sebabelz/SolderPi/pcb/bom.xlsx

Sheet: simple
Qty | Value | Device | Package | Parts | Description | OC_MOUSER | OC_DIGIKEY
2 |  | PINHD-1X2 | 1X02 | X4, X6 | PIN HEADER | 855-M20-9990246 | 952-2262-ND
1 | PINHD-2X2 | PINHD-2X2 | 2X02 | X10 | PIN HEADER | 571-5-146254-2 | 609-3242-ND
1 | 32768kHz | 9HT11 | 2X1.2 | Q2 |  | 717-9HT11-32.7KDZC-T | 887-1426-1-ND
1 | B3S-1000 | B3S-1000 | B3S | X9 |  | 653-B3S-1000 | SW415-ND
1 | MICRO-LATCH-4 | MICRO-LATCH-4 | buchse | X5 |  | 538-53253-0470 | WM19006-ND
1 | NANOFIT-2 | NANOFIT-2 | buchse |  |  | 538-105313-1102 | WM16893-ND
1 | NANOFIT-7 | NANOFIT-7 | buchse | X7 |  | 538-105313-1107 | WM16898-ND
1 | 470ÂµF | C-EEEFK | C_EEEFK-10X10 | C1 |  | 667-EEE-FK1E471P | PCE3805CT-ND
7 | 100nF | C-EUC0402 | C0402 | C11, C12, C14, C15, C16, C22, C23 | CAPACITOR, European symbol | 710-885012105016 | 732-7493-1-ND
2 | 12pF | C-EUC0402 | C0402 | C17, C18 | CAPACITOR, European symbol | 77-VJ0402A120JXAPBC | 399-1013-1-ND
2 | 1ÂµF | C-EUC0402 | C0402 | C10, C24 | CAPACITOR, European symbol | 81-GRM155R61C105MA2D | 490-12237-1-ND
2 | 22pF | C-EUC0402 | C0402 | C19, C21 | CAPACITOR, European symbol | 710-885012005027 | 732-7443-1-ND
1 | 100pF | C-EUC0603 | C0603 | C20 | CAPACITOR, European symbol | 710-885012006023 | 732-7766-1-ND
2 | 150nF | C-EUC0603 | C0603 | C7, C9 | CAPACITOR, European symbol | 810-C1608X5R1E154K | 445-7472-1-ND
2 | 1nF | C-EUC0603 | C0603 | C6, C8 | CAPACITOR, European symbol | 710-885012206059 | 732-7978-1-ND
5 | 10ÂµF | C-EUC0805 | C0805 | C2, C3, C4, C5, C14 | CAPACITOR, European symbol | 81-GRM21BR61E106MA3L | 1276-6471-1-ND
10 | MICRO-LATCH-4 | MICRO-LATCH-4 | crimp |  |  | 538-50212-8000-CT | WM4561CT-ND
10 | NANOFIT | NANOFIT | crimp |  |  | 538-105300-1100 | WM16863CT-ND
2 | JTAG-EDGE-CON | JTAG-EDGE-CON | DEBUG-CON | X8 |  | 649-1001878311110TLF | 609-1977-ND
1 | 24MHz | XRCHA_F_A | HCR2520 | Q1 |  | 81-XRCHA24M000F0A1R0 | 490-9652-1-ND
1 | IGRID-10 | IGRID-10 | IGRID-10 |  |  | 538-501646-1000 | WM6058-ND
1 | IGRID-10 | IGRID-10 | I-GRID-10 | X3 |  | 538-501645-1020 | WM6072-ND
1 | IGRID-14 | IGRID-14 | I-GRID-14 |  |  | 538-501645-1420 | WM6074-ND
1 | IGRID-14 | IGRID-14 | I-GRID-14 | X2 |  | 538-501646-1400 | WM6060-ND
1 | 50R @ 20MHz | L-0603 | L0603 | L1 |  | 81-BLM18AG151SZ1D | 732-1579-1-ND
1 | NANOFIT-2 | NANOFIT-2 | prot | X1 |  | 538-105325-1002 | WM15187-ND
1 | NANOFIT-7 | NANOFIT-7 | prot |  |  | 538-105325-1007 | WM15192-ND
2 | 1k1 | R-EU_R0603 | R0603 | R10, R16 | RESISTOR, European symbol | 603-AC0603FR-071K1L | 311-1.10KHRCT-ND
2 | 210k | R-EU_R0603 | R0603 | R4, R14 | RESISTOR, European symbol | 603-RC0603FR-10220KL | 311-210KHRCT-ND
1 | 2k2 | R-EU_R0603 | R0603 | R18 | RESISTOR, European symbol | 603-RC0603FR-072K2L | 311-2.20KHRCT-ND
1 | 330 | R-EU_R0603 | R0603 | R19 | RESISTOR, European symbol | 594-MCT06030C3300FP5 | MCT0603-330-CFCT-ND
4 | 4.7k | R-EU_R0603 | R0603 | R1, R2, R11, R12 | RESISTOR, European symbol | 603-RC0603FR-0710KL | 311-10.0KHRCT-ND
2 | 665k | R-EU_R0603 | R0603 | R3, R13 | RESISTOR, European symbol | 71-CRCW0603-665K-E3 | 311-665KHRCT-ND
4 | 4,7k | R-EU_R0805 | R0805 | R5, R6, R7, R9 | RESISTOR, European symbol | 652-CR0805-FX4701GLF | CR0805-FX-4701GLFCT-ND
2 | 20m | R-EU_R1206 | R1206 | R8, R15 | RESISTOR, European symbol | 791-WW12DR020FTL | MCS1632R020FERCT-ND
1 | 0 | R-EU_R1210 | R1210 | R17 | RESISTOR, European symbol | 603-AC1210JR-070RL | YAG3990CT-ND
2 | IRF9392PBF | IRF9392PBF | SO8 | T2, T4 |  | 942-IRF9392TRPBF | IRF7416TRPBFCT-ND
1 | LD1117S50C | LD1117S50C | SOT223 | IC1 |  | 511-LD1117S50C-TR | 497-1243-1-ND
2 | NVR4003NT3G | NVR4003NT3G | SOT23 | T1, T3 |  | 863-NVR4003NT3G | NVR4003NT3GOSCT-ND
1 |  | mcp1802 | SOT23-5L | IC3 |  | 998-MIC5504-3.3YM5TR | MCP1802T-3302I/OTCT-ND
2 | INA196 | INA196 | SOT23-5L | IC4, IC5 |  | 595-INA196AIDBVT | 296-17166-1-ND
1 | MICRO-LATCH-4 | MICRO-LATCH-4 | stecker |  |  | 538-51065-0400 | WM19011-ND
1 | NANOFIT-2 | NANOFIT-2 | stecker |  |  | 538-105307-1202 | WM14958-ND
1 | NANOFIT-7 | NANOFIT-7 | stecker |  |  | 538-105307-1207 | WM15013-ND
1 | ATSAMC21G | ATSAMC21G | TQFP48 | IC6 |  | 556-ATSAMC21G18A-AUT | ATSAMC21G18A-AUTCT-ND
1 | ST2378E | ST2378E | TSSOP20 | IC2 |  | 511-ST2378ET | 497-3730-1-ND

Sheet: display
Qty | Value | Device | Package | Parts | Description | OC_MOUSER | OC_DIGIKEY
1 |  | PINHD-1X16 | 1X16 | X1 | PIN HEADER | 437-8018701610001101 | S7014-ND
1 |  | PINHD-2X6 | 2X06 | JP1 | PIN HEADER | 855-M20-9760642 | S2012EC-06-ND
1 | 100nF | C-EUC0805 | C0805 | C1 | CAPACITOR, European symbol | 710-885012207072 | 1276-2448-1-ND
1 | 1k | R-EU_R0805 | R0805 | R2 | RESISTOR, European symbol | 603-RC0805JR-7W1KL | 311-1.0KARCT-ND
1 | 294 | R-EU_R0805 | R0805 | R1 | RESISTOR, European symbol | 71-CRCW0805-294-E3 | 541-294CCT-ND
1 | MCP23017SO | MCP23017SO | SO28W | IC1 | http://ww1.microchip.com/downloads/en/DeviceDoc/21952a.pdf | 579-MCP23017-E/SO | MCP23017T-E/SOCT-ND
1 | MCP4018 | MCP4018 | SC70-6L | IC2 |  | 579-MCP4018T502ELT | MCP4018T-502E/LTCT-ND

Sheet: iron
Qty | Value | Device | Package | Parts | Description | OC_MOUSER | OC_DIGIKEY
1 | 100pF | C-EUC0805 | C0805 | C1 | CAPACITOR, European symbol | 710-885012207080 | 1276-1014-1-ND
1 | 10nF | C-EUC0805 | C0805 | C2 | CAPACITOR, European symbol | 710-885012207092 | 478-1383-1-ND
2 | 1M 0,1% | R-EU_R0805 | R0805 | R8, R9 | RESISTOR, European symbol | 603-RT0805BRD071ML | YAG4967CT-ND
2 | 1k | R-EU_R0805 | R0805 | R5, R6 | RESISTOR, European symbol | 71-CRCW08051K00FKEAC | 311-1.00KCRCT-ND
1 | 20k 0,1% | R-EU_R0805 | R0805 | R1 | RESISTOR, European symbol | 756-PCF0805R20KBI | P20KDACT-ND
2 | 2k 0.1% | R-EU_R0805 | R0805 | R7 | RESISTOR, European symbol | 279-RN73C2A2K0BTD | P20626CT-ND
1 | 5,1M | R-EU_R0805 | R0805 | R4 | RESISTOR, European symbol | 603-RC0805FR-075M1L | RMCF0805FT5M10CT-ND
1 | 68k @25Â°C, 1%, ÃŸ=4100 K | NTC-0805 | R0805 | R2 |  | 594-NTCS0805E3683FXT | 445-180069-1-ND
1 | AD7995 | AD7995 | SOT23-8 | IC3 |  | 584-AD7995YRJZ0500R7 | AD7995YRJZ-0500RL7CT-ND
1 | AT24CS04-SOT23 | AT24CS04-SOT23 | SOT23-5L | IC1 |  | 556-AT24CS04-STUM-T | AT24CS04-STUM-TCT-ND
1 | ESDA6V1SC5 | ESDA6V1SC5 | SOT23-5L | IC4 |  | 511-ESDA6V1SC5 | 497-7748-1-ND
1 | TS507CLT | TS507CLT | SOT23-5L | IC2 |  | 511-TS507CLT | 497-6944-1-ND

Sheet: tweezer
Qty | Value | Device | Package | Parts | Description | OC_MOUSER | OC_DIGIKEY
1 | 100pF | C-EUC0805 | C0805 | C1 | CAPACITOR, European symbol | 710-885012207080 | 1276-1014-1-ND
2 | 10nF | C-EUC0805 | C0805 | C2, C3 | CAPACITOR, European symbol | 710-885012207092 | 478-1383-1-ND
4 | 1M 0,1% | R-EU_R0805 | R0805 | R8, R9, R12, R13 | RESISTOR, European symbol | 603-RT0805BRD071ML | YAG4967CT-ND
2 | 1k | R-EU_R0805 | R0805 | R5, R6 | RESISTOR, European symbol | 71-CRCW08051K00FKEAC | 311-1.00KCRCT-ND
1 | 20k 0,1% | R-EU_R0805 | R0805 | R1 | RESISTOR, European symbol | 756-PCF0805R20KBI | P20KDACT-ND
4 | 2k 0.1% | R-EU_R0805 | R0805 | R7, R11 | RESISTOR, European symbol | 279-RN73C2A2K0BTD | P20626CT-ND
1 | 5,1M | R-EU_R0805 | R0805 | R4 | RESISTOR, European symbol | 603-RC0805FR-075M1L | RMCF0805FT5M10CT-ND
1 | 68k @25°C, 1%, ß=4100 K | NTC-0805 | R0805 | R2 |  | 594-NTCS0805E3683FXT | 445-180069-1-ND
1 | AD7995 | AD7995 | SOT23-8 | IC1 |  | 584-AD7995YRJZ0500R7 | AD7995YRJZ-0500RL7CT-ND
1 | AT24CS04-SOT23 | AT24CS04-SOT23 | SOT23-5L | IC6 |  | 556-AT24CS04-STUM-T | AT24CS04-STUM-TCT-ND
1 | ESDA6V1SC5 | ESDA6V1SC5 | SOT23-5L | IC5 |  | 511-ESDA6V1SC5 | 497-7748-1-ND
2 | TS507CLT | TS507CLT | SOT23-5L | IC2, IC3 |  | 511-TS507CLT | 497-6944-1-ND

Sheet: encoder
Qty | Value | Device | Package | Parts | Description | OC_MOUSER | OC_DIGIKEY
12 | 10nF | C-EUC0805 | C0805 | C1, C2, C3, C4, C5, C7, C10, C11, C12, C14, C15, C16 | CAPACITOR, European symbol | 710-885012207072 | 478-1383-1-ND
20 | 10k | R-EU_R0805 | R0805 | R1, R2, R3, R4, R5, R6, R7, R8, R9, R10, R13, R14, R15, R16, R17, R18, R19, R20, R21, R22 | RESISTOR, European symbol | 71-CRCW080510K0FKEAC | 311-10.0KCRCT-ND
6 | 1µF | C-EUC0805 | C0805 | C6, C8, C9, C13, C17, C18 | CAPACITOR, European symbol | 80-C0805C105M3R | 1276-1026-1-ND
4 | 22k | R-EU_R0805 | R0805 | R11, R12, R23, R24 | RESISTOR, European symbol | 603-RC0805FR-0722KL | RMCF0805FT22K0CT-ND
