sebabelz/SolderPi/pcb/simple_encoder.brd

## EAGLE design pcb/simple_encoder.brd (2018-05-25)

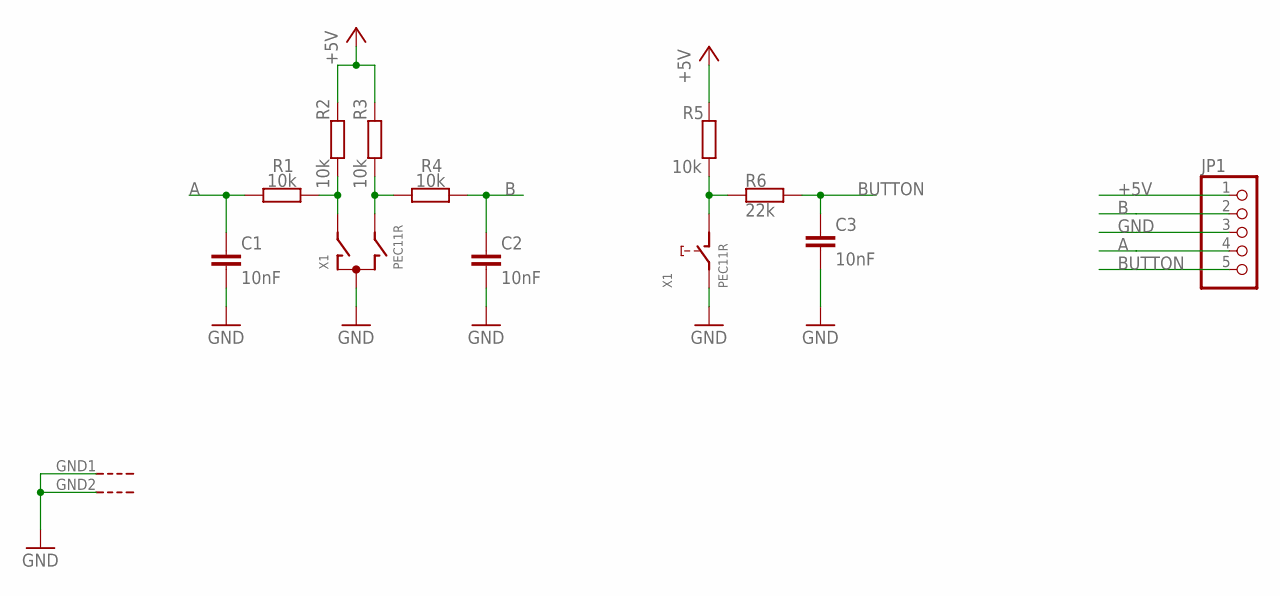
[picture p1: schematic simple_encoder.sch]

Parts:
C1, C2, C3: 10nF; C0805
JP1: PINHD-1X5; 1X05
R1, R2, R3, R4, R5: 10k; R0805
R6: 22k; R0805
X1: PEC11R

Connections:
+5V: JP1.1, R2.2, R3.2, R5.2
A: C1.1, JP1.4, R1.1
A_UNFIL: R1.2, R2.1, X1.A
B: C2.1, JP1.2, R4.2
BUTTON: C3.1, JP1.5, R6.2
BUTTON_UNFIL: R5.1, R6.1, X1.D
B_UNFIL: R3.1, R4.1, X1.B
GND: C1.2, C2.2, C3.2, JP1.3, X1.C, X1.E, X1.GND1 (G), X1.GND2 (G)

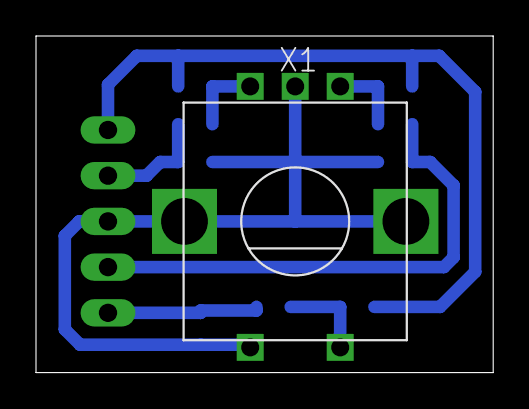
[picture p2: board simple_encoder.brd from above]

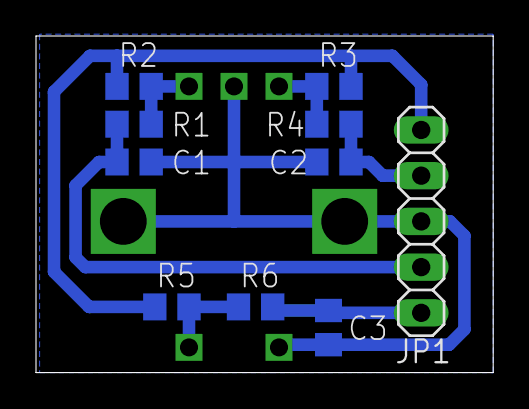
[picture p3: board simple_encoder.brd from below]

Board: 2 copper layers, 25.4 x 18.7 mm, 11 parts (10 on the bottom side), 8 nets.
