sebabelz/SolderPi/pcb/simple_controller.brd

## EAGLE design pcb/simple_controller.brd (2018-05-25)

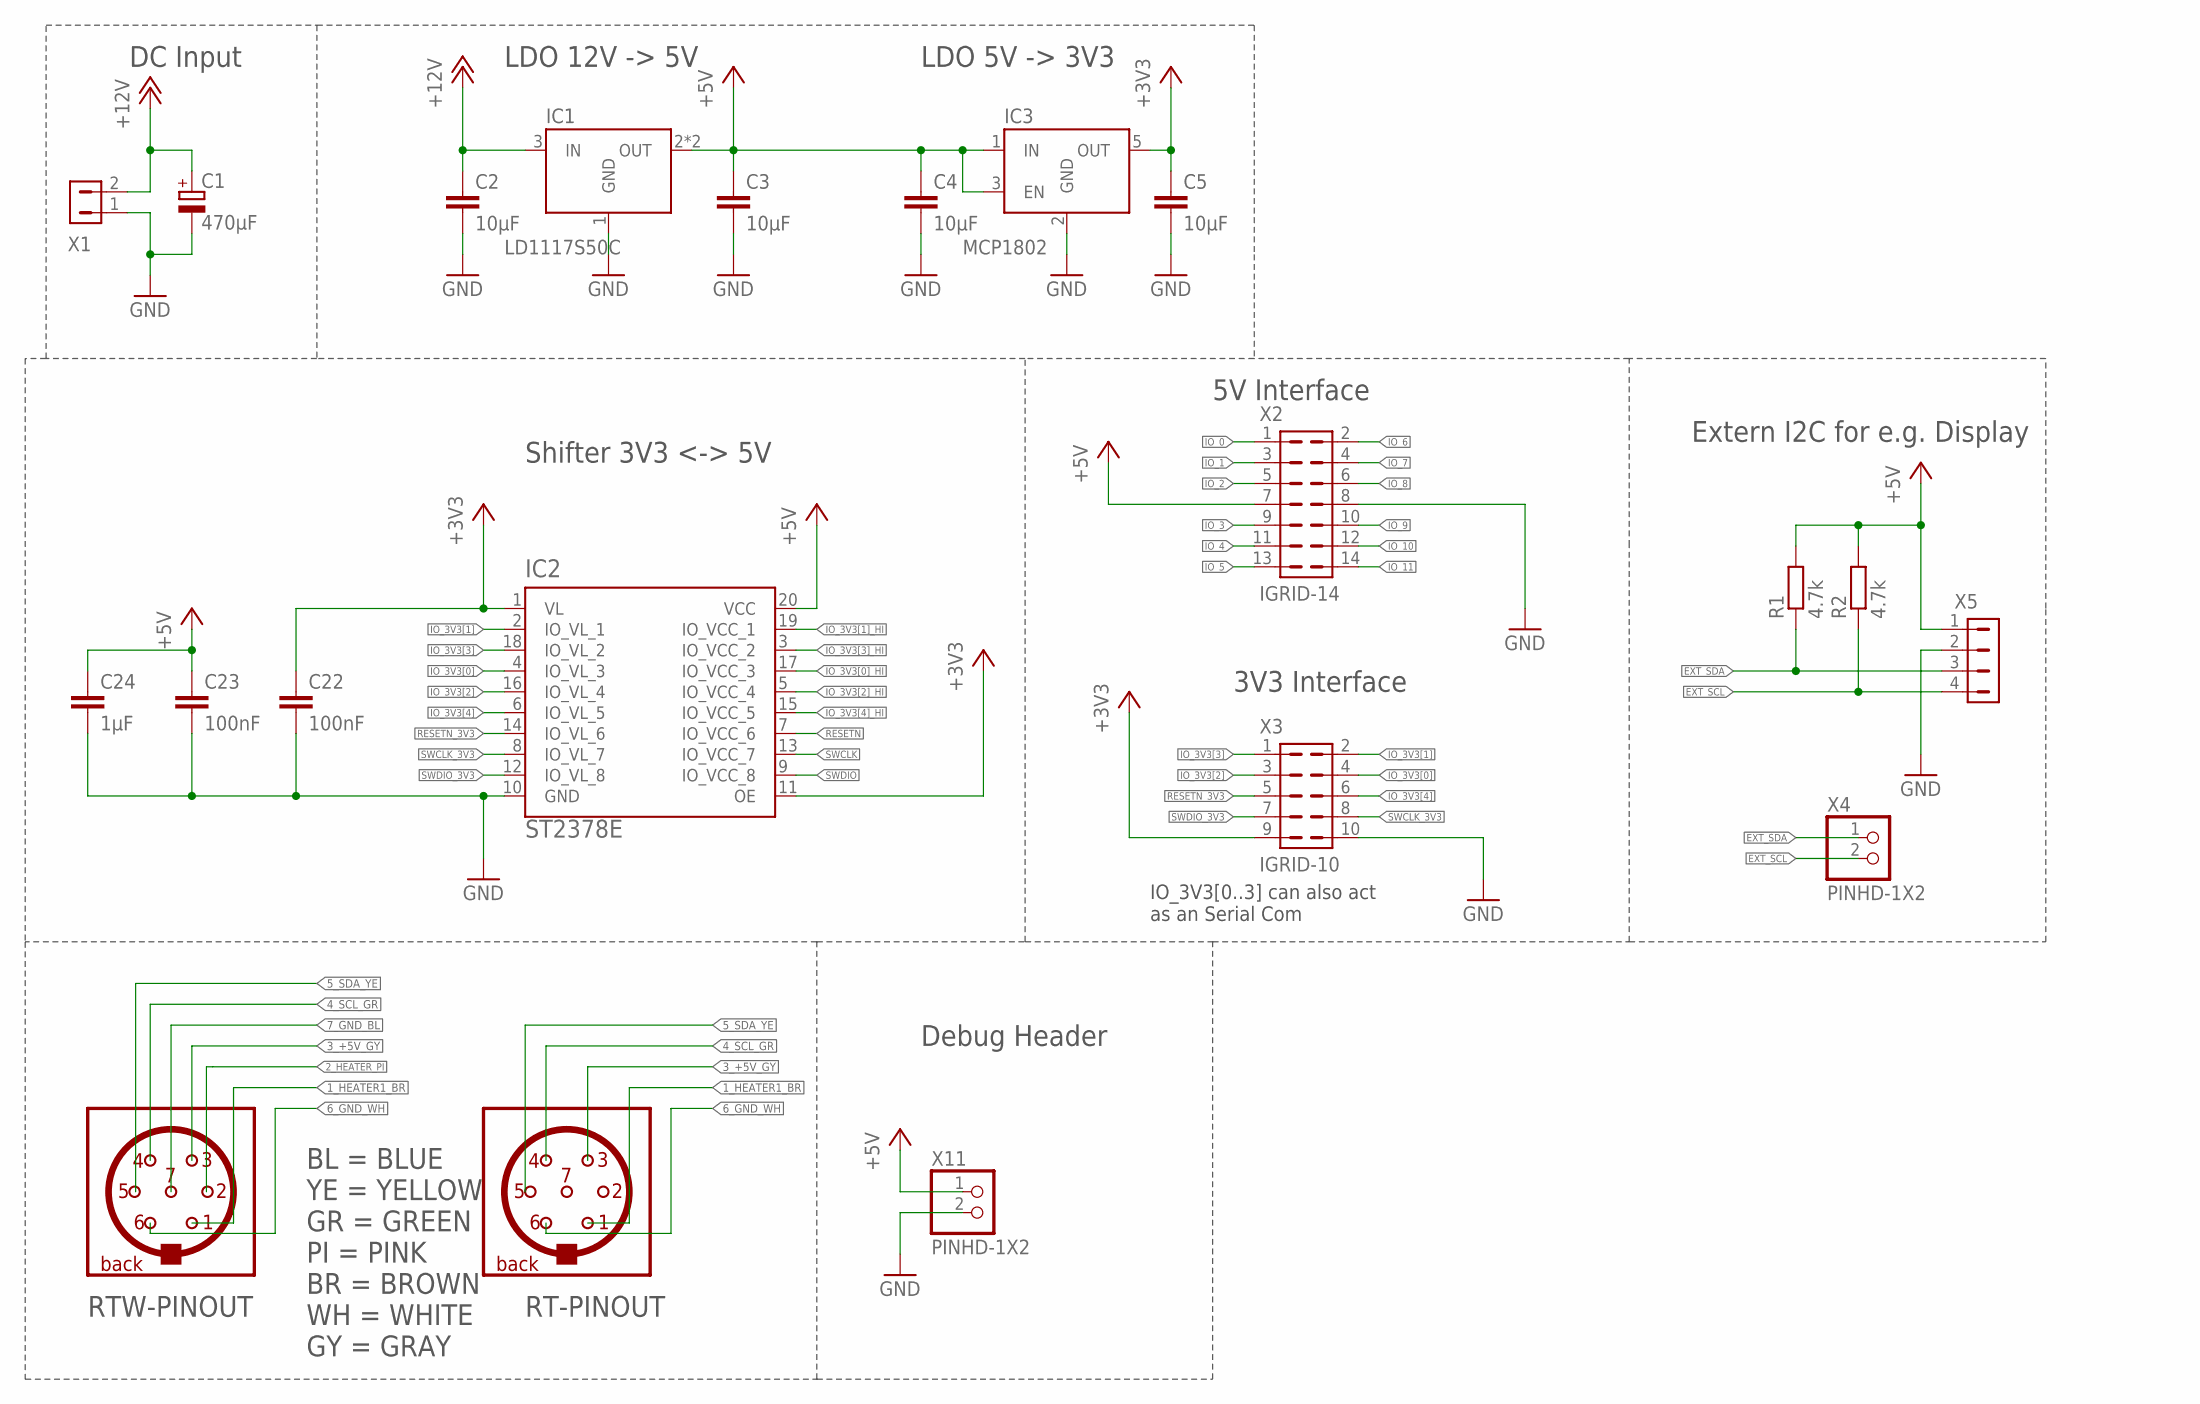
[picture p4: schematic simple_controller.sch, sheet 1]

Parts:
C1: 470µF; C_EEEFK-10X10
C2, C3, C4, C5: 10µF; C0805
C22, C23: 100nF; C0402
C24: 1µF; C0402
IC1: LD1117S50C; SOT223
IC2: ST2378E; TSSOP20
IC3: MCP1802; SOT23-5L
R1, R2: 4.7k; R0603
X1: NANOFIT-2; NANOFIT-2-90
X2: IGRID-14; I-GRID-14
X3: IGRID-10; I-GRID-10
X4, X11: PINHD-1X2; 1X02
X5: MICRO-LATCH-4

Connections:
+3V3: C5.1, C22.1, IC2.1 (VL), IC2.11 (OE), IC3.5 (OUT), X3.9
+5V: C3.1, C4.1, C23.1, C24.1, IC1.2 (OUT), IC1.4 (OUT), IC2.20 (VCC), IC3.1 (IN), IC3.3 (EN), R1.2, R2.2, X2.7, X5.1, X11.1; also elsewhere on the board
+12V: C1.+, C2.1, IC1.3 (IN), X1.2; also elsewhere on the board
EXT_SCL: R2.1, X4.2, X5.4; also elsewhere on the board
EXT_SDA: R1.1, X4.1, X5.3; also elsewhere on the board
GND: C1.-, C2.2, C3.2, C4.2, C5.2, C22.2, C23.2, C24.2, IC1.1 (GND), IC2.10 (GND), IC3.2 (GND), X1.1, X2.8, X3.10, X5.2, X11.2; also elsewhere on the board
IO_0: X2.1; also elsewhere on the board
IO_1: X2.3; also elsewhere on the board
IO_2: X2.5; also elsewhere on the board
IO_3: X2.9; also elsewhere on the board
IO_3V3[0]: IC2.4 (IO_VL_3), X3.4
IO_3V3[0]_HI: IC2.17 (IO_VCC_3); also elsewhere on the board
IO_3V3[1]: IC2.2 (IO_VL_1), X3.2
IO_3V3[1]_HI: IC2.19 (IO_VCC_1); also elsewhere on the board
IO_3V3[2]: IC2.16 (IO_VL_4), X3.3
IO_3V3[2]_HI: IC2.5 (IO_VCC_4); also elsewhere on the board
IO_3V3[3]: IC2.18 (IO_VL_2), X3.1
IO_3V3[3]_HI: IC2.3 (IO_VCC_2); also elsewhere on the board
IO_3V3[4]: IC2.6 (IO_VL_5), X3.6
IO_3V3[4]_HI: IC2.15 (IO_VCC_5); also elsewhere on the board
IO_4: X2.11; also elsewhere on the board
IO_5: X2.13; also elsewhere on the board
IO_6: X2.2; also elsewhere on the board
IO_7: X2.4; also elsewhere on the board
IO_8: X2.6; also elsewhere on the board
IO_9: X2.10; also elsewhere on the board
IO_10: X2.12; also elsewhere on the board
IO_11: X2.14; also elsewhere on the board
RESETN: IC2.7 (IO_VCC_6); also elsewhere on the board
RESETN_3V3: IC2.14 (IO_VL_6), X3.5
SWCLK: IC2.13 (IO_VCC_7); also elsewhere on the board
SWCLK_3V3: IC2.8 (IO_VL_7), X3.8
SWDIO: IC2.9 (IO_VCC_8); also elsewhere on the board
SWDIO_3V3: IC2.12 (IO_VL_8), X3.7

Notes on the sheet:
LDO 12V -> 5V
LDO 5V -> 3V3
3V3 Interface
Shifter 3V3 <-> 5V
Extern I2C for e.g. Display
BL = BLUE YE = YELLOW GR = GREEN PI = PINK BR = BROWN WH = WHITE GY = GRAY
RTW-PINOUT
RT-PINOUT
IO_3V3[0..3] can also act as an Serial Com
DC Input
5V Interface
Debug Header

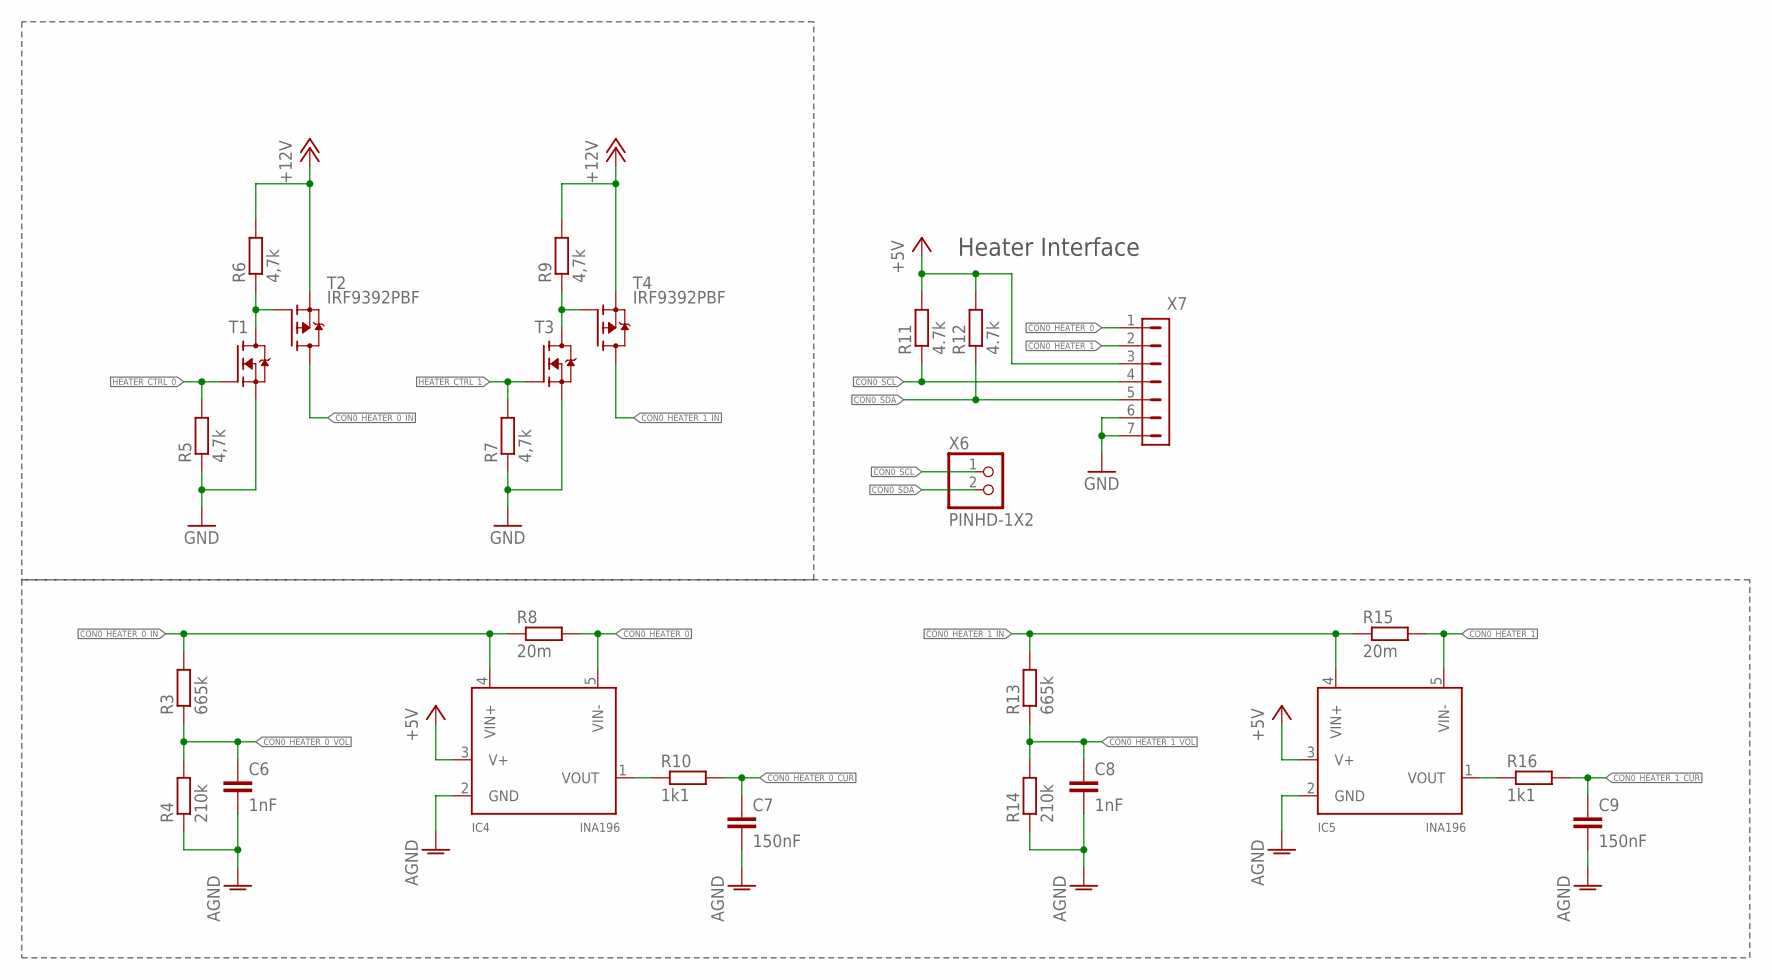
[picture p5: schematic simple_controller.sch, sheet 2]

Parts:
C6, C8: 1nF; C0603
C7, C9: 150nF; C0603
IC4, IC5: INA196; SOT23-5L
R3, R13: 665k; R0603
R4, R14: 210k; R0603
R5, R6, R7, R9: 4,7k; R0805
R8, R15: 20m; R1206
R10, R16: 1k1; R0603
R11, R12: 4.7k; R0603
T1, T3: NVR4003NT3G; SOT23
T2, T4: IRF9392PBF; SO8
X6: PINHD-1X2; 1X02
X7: NANOFIT-7

Connections:
+5V: IC4.3 (V+), IC5.3 (V+), R11.2, R12.2, X7.3; also elsewhere on the board
+12V: R6.2, R9.2, T2.1 (S), T2.2 (S), T2.3 (S), T4.1 (S), T4.2 (S), T4.3 (S); also elsewhere on the board
AGND: C6.2, C7.2, C8.2, C9.2, IC4.2 (GND), IC5.2 (GND), R4.1, R14.1; also elsewhere on the board
CON0_HEATER_0: IC4.5 (VIN-), R8.2, X7.1
CON0_HEATER_0_CUR: C7.1, R10.2; also elsewhere on the board
CON0_HEATER_0_IN: IC4.4 (VIN+), R3.2, R8.1, T2.5 (D), T2.6 (D), T2.7 (D), T2.8 (D)
CON0_HEATER_0_VOL: C6.1, R3.1, R4.2; also elsewhere on the board
CON0_HEATER_1: IC5.5 (VIN-), R15.2, X7.2
CON0_HEATER_1_CUR: C9.1, R16.2; also elsewhere on the board
CON0_HEATER_1_IN: IC5.4 (VIN+), R13.2, R15.1, T4.5 (D), T4.6 (D), T4.7 (D), T4.8 (D)
CON0_HEATER_1_VOL: C8.1, R13.1, R14.2; also elsewhere on the board
CON0_SCL: R11.1, X6.1, X7.4; also elsewhere on the board
CON0_SDA: R12.1, X6.2, X7.5; also elsewhere on the board
GND: R5.1, R7.1, T1.2 (S), T3.2 (S), X7.6, X7.7; also elsewhere on the board
HEATER0_AD_OUT0: IC4.1 (VOUT), R10.1
HEATER0_AD_OUT1: IC5.1 (VOUT), R16.1
HEATER0_G0: R6.1, T1.3 (D), T2.4 (G)
HEATER0_G1: R9.1, T3.3 (D), T4.4 (G)
HEATER_CTRL_0: R5.2, T1.1 (G); also elsewhere on the board
HEATER_CTRL_1: R7.2, T3.1 (G); also elsewhere on the board

Notes on the sheet:
Heater Interface

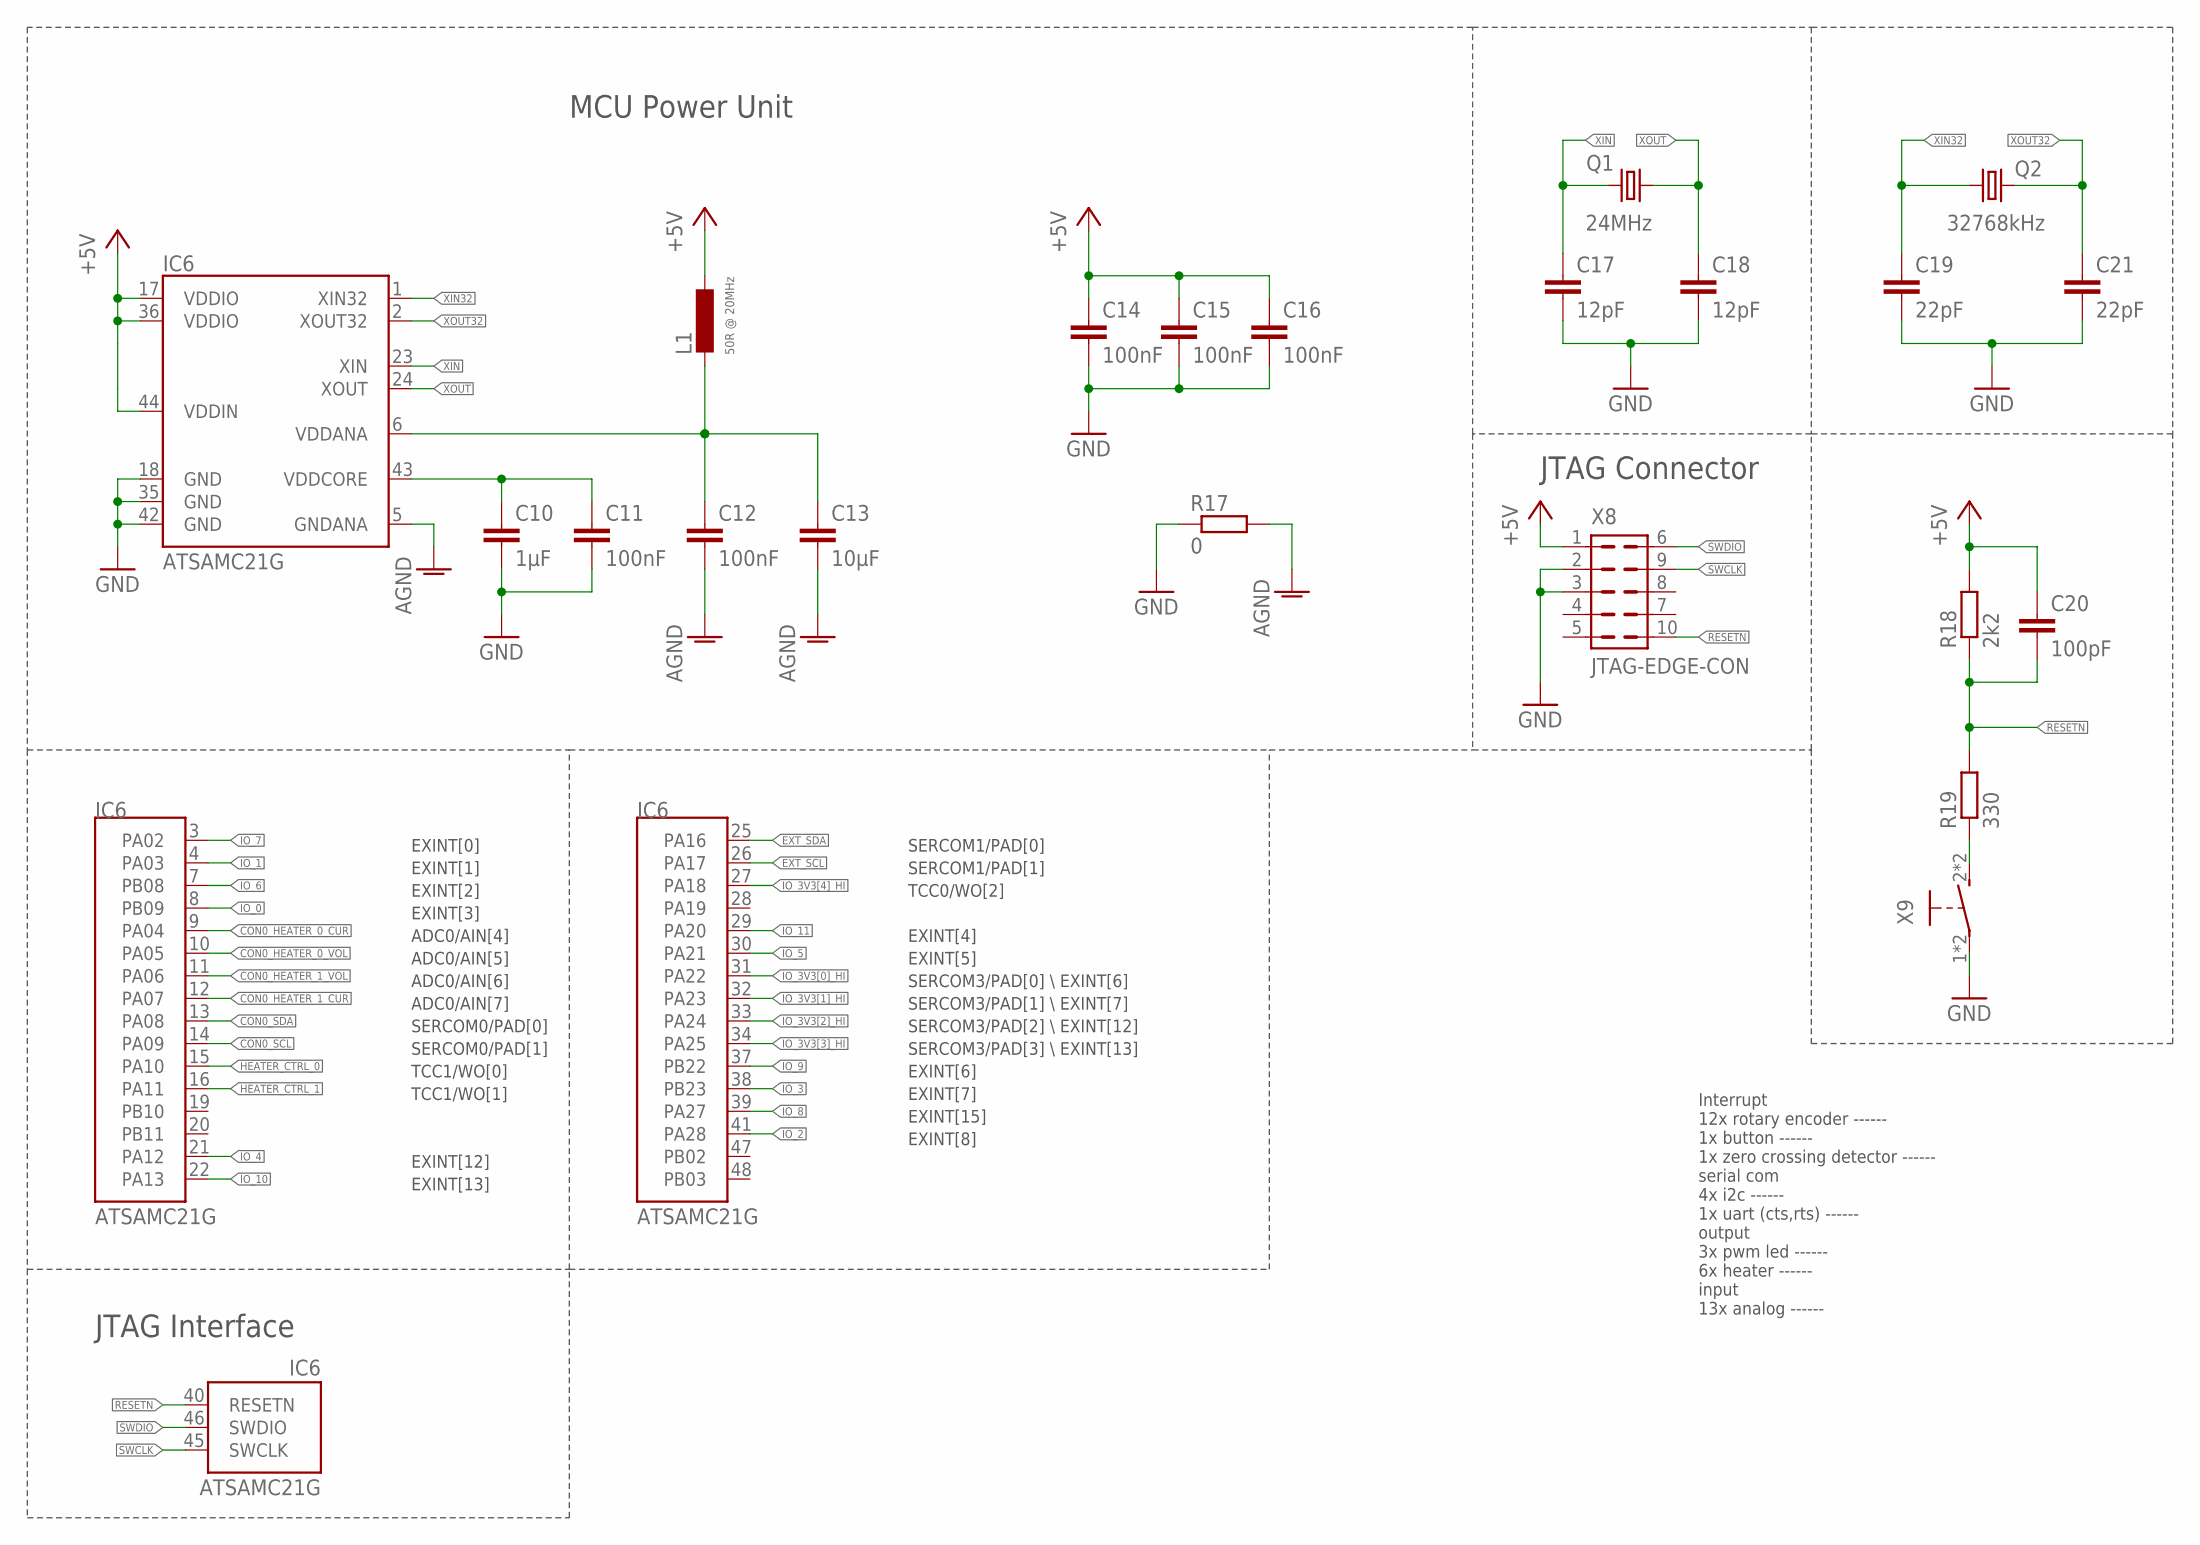
[picture p6: schematic simple_controller.sch, sheet 3]

Parts:
C10: 1µF; C0402
C11, C12, C14, C15, C16: 100nF; C0402
C13: 10µF; C0805
C17, C18: 12pF; C0402
C19, C21: 22pF; C0402
C20: 100pF; C0603
IC6: ATSAMC21G; TQFP48
L1: 50R @ 20MHz; L0603
Q1: 24MHz; HCR2520
Q2: 32768kHz; 2X1.2
R17: 0; R1210
R18: 2k2; R0603
R19: 330; R0603
X8: JTAG-EDGE-CON; DEBUG-CON
X9: B3S-1000; B3S

Connections:
+5V: C14.1, C15.1, C16.1, C20.1, IC6.17 (VDDIO), IC6.36 (VDDIO), IC6.44 (VDDIN), L1.1, R18.2, X8.1; also elsewhere on the board
AGND: C12.2, C13.2, IC6.5 (GNDANA), R17.2; also elsewhere on the board
CON0_HEATER_0_CUR: IC6.9 (PA04); also elsewhere on the board
CON0_HEATER_0_VOL: IC6.10 (PA05); also elsewhere on the board
CON0_HEATER_1_CUR: IC6.12 (PA07); also elsewhere on the board
CON0_HEATER_1_VOL: IC6.11 (PA06); also elsewhere on the board
CON0_SCL: IC6.14 (PA09); also elsewhere on the board
CON0_SDA: IC6.13 (PA08); also elsewhere on the board
EXT_SCL: IC6.26 (PA17); also elsewhere on the board
EXT_SDA: IC6.25 (PA16); also elsewhere on the board
GND: C10.2, C11.2, C14.2, C15.2, C16.2, C17.2, C18.2, C19.2, C21.2, IC6.18 (GND), IC6.35 (GND), IC6.42 (GND), R17.1, X8.2, X8.3, X9.1, X9.3; also elsewhere on the board
HEATER_CTRL_0: IC6.15 (PA10); also elsewhere on the board
HEATER_CTRL_1: IC6.16 (PA11); also elsewhere on the board
IO_0: IC6.8 (PB09); also elsewhere on the board
IO_1: IC6.4 (PA03); also elsewhere on the board
IO_2: IC6.41 (PA28); also elsewhere on the board
IO_3: IC6.38 (PB23); also elsewhere on the board
IO_3V3[0]_HI: IC6.31 (PA22); also elsewhere on the board
IO_3V3[1]_HI: IC6.32 (PA23); also elsewhere on the board
IO_3V3[2]_HI: IC6.33 (PA24); also elsewhere on the board
IO_3V3[3]_HI: IC6.34 (PA25); also elsewhere on the board
IO_3V3[4]_HI: IC6.27 (PA18); also elsewhere on the board
IO_4: IC6.21 (PA12); also elsewhere on the board
IO_5: IC6.30 (PA21); also elsewhere on the board
IO_6: IC6.7 (PB08); also elsewhere on the board
IO_7: IC6.3 (PA02); also elsewhere on the board
IO_8: IC6.39 (PA27); also elsewhere on the board
IO_9: IC6.37 (PB22); also elsewhere on the board
IO_10: IC6.22 (PA13); also elsewhere on the board
IO_11: IC6.29 (PA20); also elsewhere on the board
RESETN: C20.2, IC6.40 (RESETN), R18.1, R19.2, X8.10; also elsewhere on the board
RESET_SW_IN: R19.1, X9.2 (S), X9.4 (S)
SWCLK: IC6.45 (SWCLK), X8.9; also elsewhere on the board
SWDIO: IC6.46 (SWDIO), X8.6; also elsewhere on the board
VDDANA: C12.1, C13.1, IC6.6 (VDDANA), L1.2
VDDCORE: C10.1, C11.1, IC6.43 (VDDCORE)
XIN: C17.1, IC6.23 (XIN), Q1.1
XIN32: C19.1, IC6.1 (XIN32), Q2.1
XOUT: C18.1, IC6.24 (XOUT), Q1.2
XOUT32: C21.1, IC6.2 (XOUT32), Q2.2

Notes on the sheet:
Interrupt 12x rotary encoder ------ 1x button ------ 1x zero crossing detector ------ serial com 4x i2c ------ 1x uart (cts,rts) ------ output 3x pwm led ------ 6x heater ------ input 13x analog ------
JTAG Interface
JTAG Connector
MCU Power Unit
TCC1/WO[1]
TCC1/WO[0]
ADC0/AIN[4]
ADC0/AIN[5]
ADC0/AIN[6]
ADC0/AIN[7]
SERCOM0/PAD[0]
SERCOM0/PAD[1]
SERCOM1/PAD[0]
SERCOM1/PAD[1]
SERCOM3/PAD[0] \\ EXINT[6]
SERCOM3/PAD[1] \\ EXINT[7]
SERCOM3/PAD[2] \\ EXINT[12]
SERCOM3/PAD[3] \\ EXINT[13]
TCC0/WO[2]
EXINT[3]
EXINT[2]
EXINT[1]
EXINT[0]
EXINT[8]
EXINT[15]
EXINT[7]
EXINT[6]
EXINT[13]
EXINT[12]
EXINT[4]
EXINT[5]

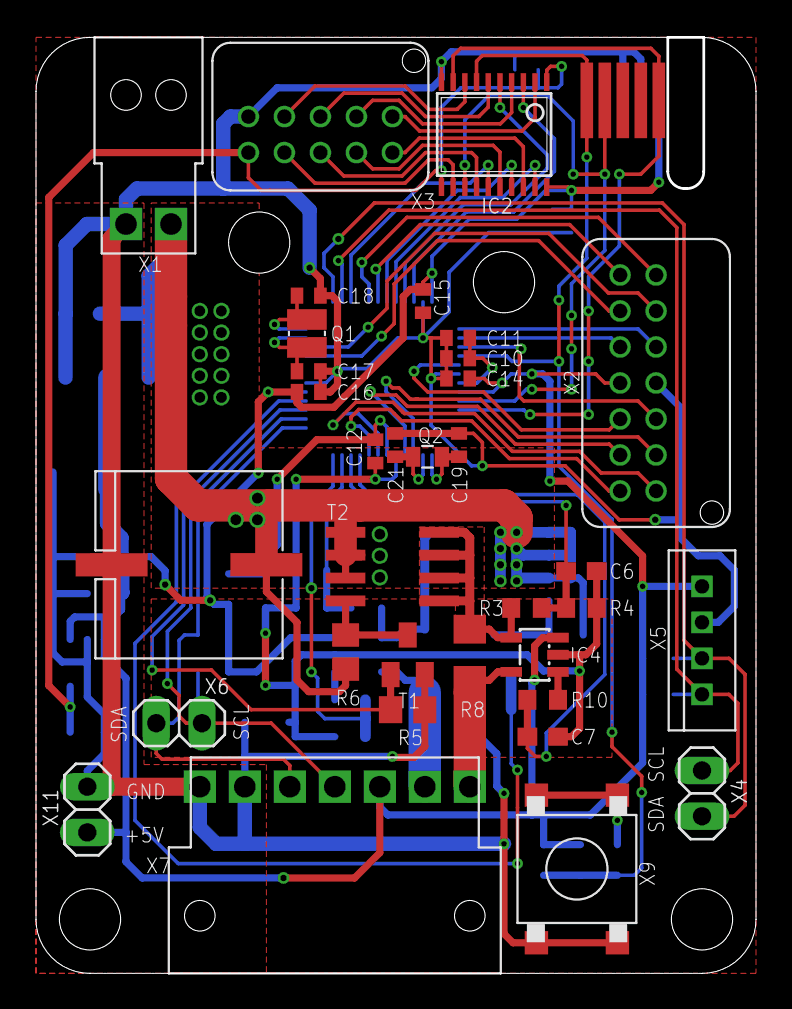
[picture p7: board simple_controller.brd from above]

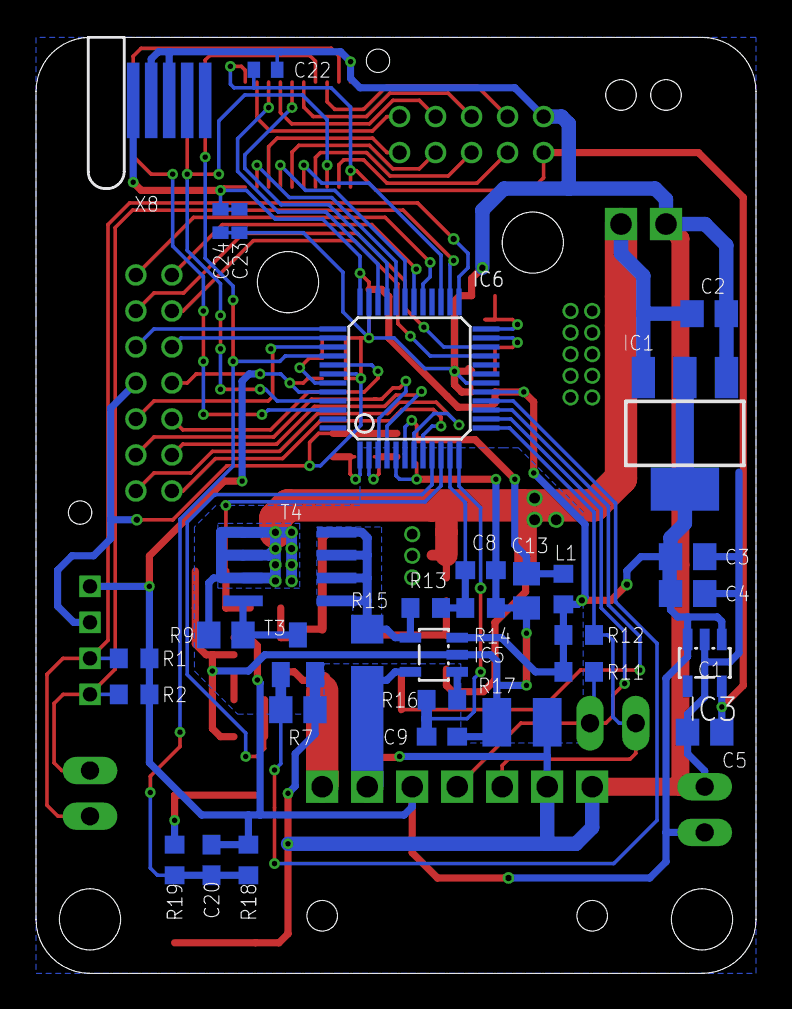
[picture p8: board simple_controller.brd from below]

Board: 2 copper layers, 40.0 x 52.0 mm, 66 parts (32 on the bottom side), 58 nets.
