sebabelz/SolderPi/pcb/tweezer.brd

## EAGLE design pcb/tweezer.brd (2018-05-15)

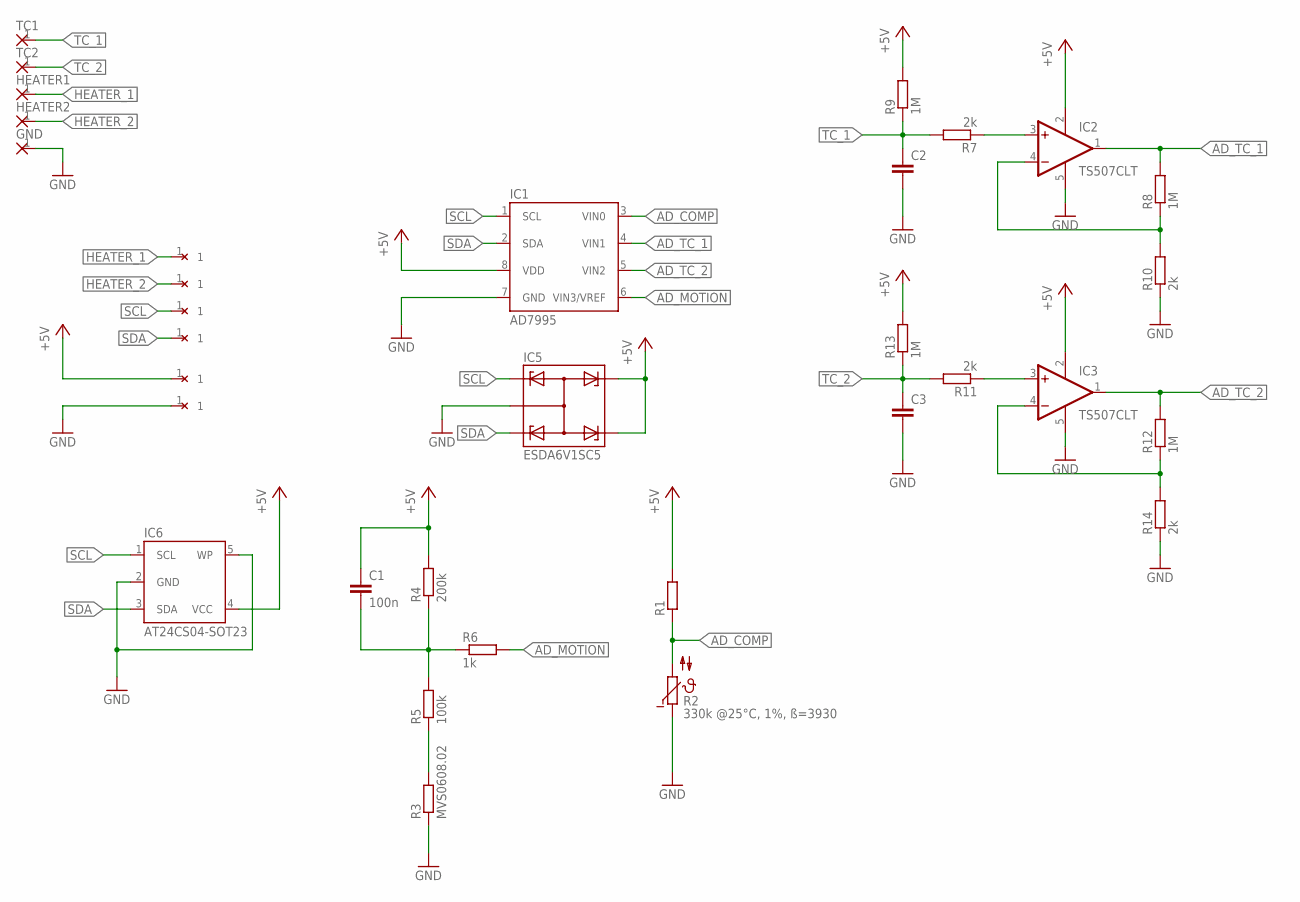
[picture p9: schematic tweezer.sch]

Parts:
21: WIREPAD
C1: 100n; C0805
C2, C3: C-EUC0805; C0805
GND: 1,6/0,8
HEATER1, HEATER2: 1,6/0,8
IC1: AD7995; SOT23-8
IC2, IC3: TS507CLT; SOT23-5L
IC5: ESDA6V1SC5; SOT23-5L
IC6: AT24CS04-SOT23; SOT23-5L
R1: R-EU_R0805; R0805
R2: 330k @25°C, 1%, ß=3930; R0805
R3: MVS0608.02; VIBRA-SNS
R4: 200k; R0805
R5: 100k; R0805
R6: 1k; R0805
R7, R10, R11, R14: 2k; R0805
R8, R9, R12, R13: 1M; R0805
TC1, TC2: 1,6/0,8
U$7, U$9, U$10, U$11: WIREPAD
ß: WIREPAD

Connections:
+5V: C1.1, IC1.8 (VDD), IC2.2 (V+), IC3.2 (V+), IC5.4, IC5.5, IC6.4 (VCC), R1.2, R4.2, R9.2, R13.2, U$10.1
AD_COMP: IC1.3 (VIN0), R1.1, R2.2
AD_MOTION: IC1.6 (VIN3/VREF), R6.2
AD_TC_1: IC1.4 (VIN1), IC2.1 (OUT), R8.2
AD_TC_2: IC1.5 (VIN2), IC3.1 (OUT), R12.2
FEEDBACK1: IC3.4 (-IN), R12.1, R14.2
FEEDBACK_TC_1: IC2.4 (-IN), R8.1, R10.2
GND: C2.2, C3.2, GND.1, IC1.7 (GND), IC2.5 (V-), IC3.5 (V-), IC5.2, IC6.2 (GND), IC6.5 (WP), R2.1, R3.P$1 (1), R10.1, R14.1, U$11.1
HEATER_1: HEATER1.1, ß.1
HEATER_2: HEATER2.1, U$7.1
MOTION_DIV: R3.P$2 (2), R5.1
MOTION_FIL: C1.2, R4.1, R5.2, R6.1
SCL: 21.1, IC1.1 (SCL), IC5.1, IC6.1 (SCL)
SDA: IC1.2 (SDA), IC5.3, IC6.3 (SDA), U$9.1
TC_1: C2.1, R7.2, R9.1, TC1.1
TC_2: C3.1, R11.2, R13.1, TC2.1
THERMO_FIL1: IC3.3 (+IN), R11.1
THERMO_FIL_TC_1: IC2.3 (+IN), R7.1

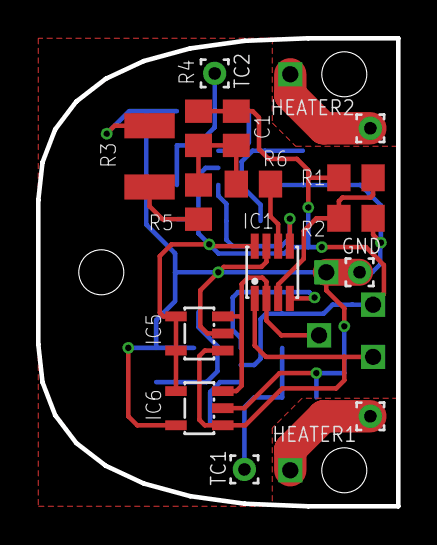
[picture p10: board tweezer.brd from above]

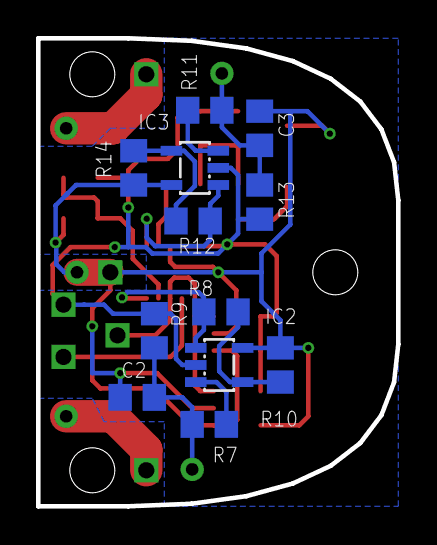
[picture p11: board tweezer.brd from below]

Board: 2 copper layers, 20.0 x 26.0 mm, 33 parts (12 on the bottom side), 18 nets.
