sebabelz/SolderPi/pcb/display.brd

## EAGLE design pcb/display.brd (2018-05-15)

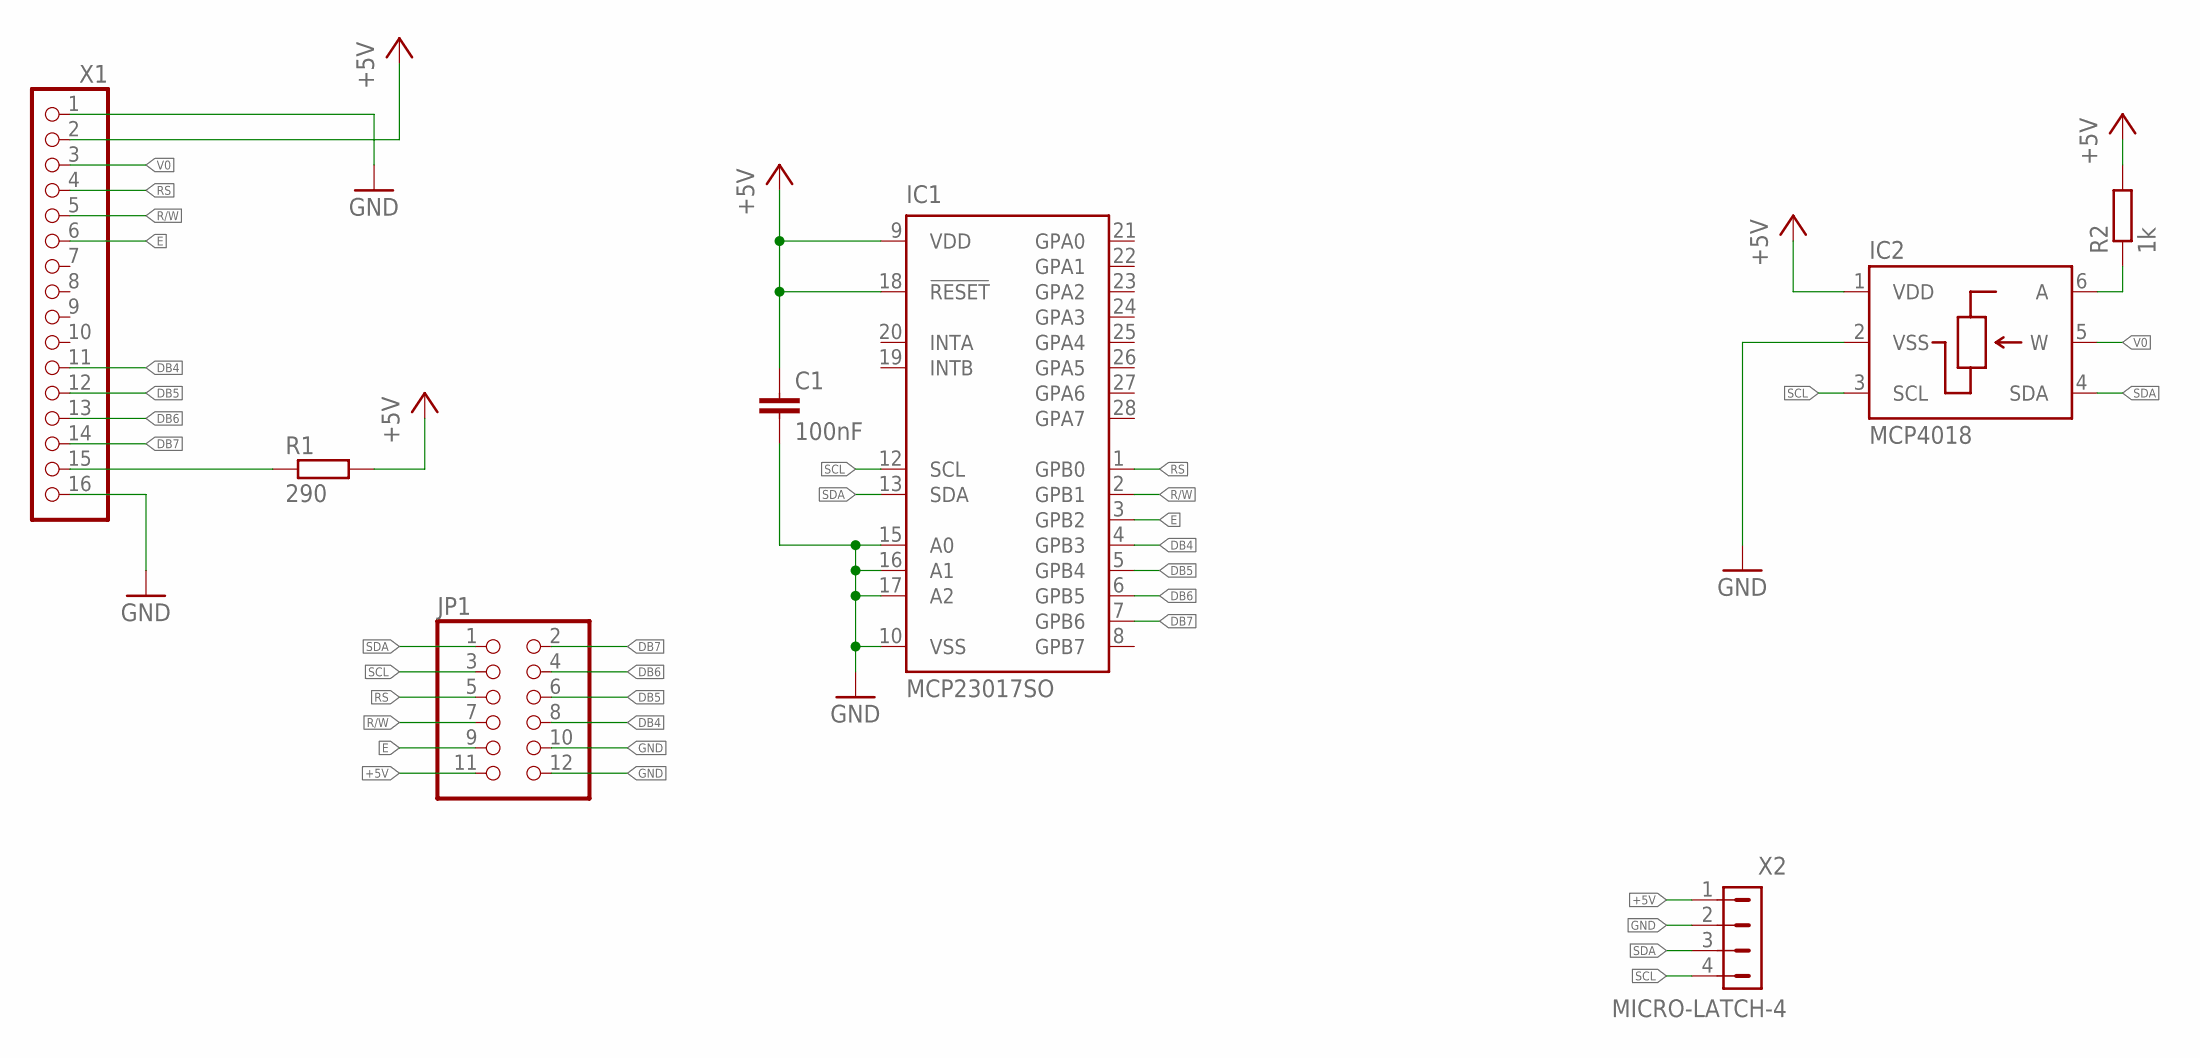
[picture p12: schematic display.sch]

Parts:
C1: 100nF; C0805
IC1: MCP23017SO; SO28W
IC2: MCP4018; SC70-6L
JP1: PINHD-2X6; 2X06
R1: 290; R0805
R2: 1k; R0805
X1: PINHD-1X16; 1X16
X2: MICRO-LATCH-4

Connections:
+5V: C1.1, IC1.9 (VDD), IC1.18 (!RESET), IC2.1 (VDD), JP1.11, R1.2, R2.2, X1.2, X2.1
DB4: IC1.4 (GPB3), JP1.8, X1.11
DB5: IC1.5 (GPB4), JP1.6, X1.12
DB6: IC1.6 (GPB5), JP1.4, X1.13
DB7: IC1.7 (GPB6), JP1.2, X1.14
E: IC1.3 (GPB2), JP1.9, X1.6
GND: C1.2, IC1.10 (VSS), IC1.15 (A0), IC1.16 (A1), IC1.17 (A2), IC2.2 (VSS), JP1.10, JP1.12, X1.1, X1.16, X2.2
unnamed: R1.1, X1.15
unnamed: IC2.6 (A), R2.1
R/W: IC1.2 (GPB1), JP1.7, X1.5
RS: IC1.1 (GPB0), JP1.5, X1.4
SCL: IC1.12 (SCL), IC2.3 (SCL), JP1.3, X2.4
SDA: IC1.13 (SDA), IC2.4 (SDA), JP1.1, X2.3
V0: IC2.5 (W), X1.3

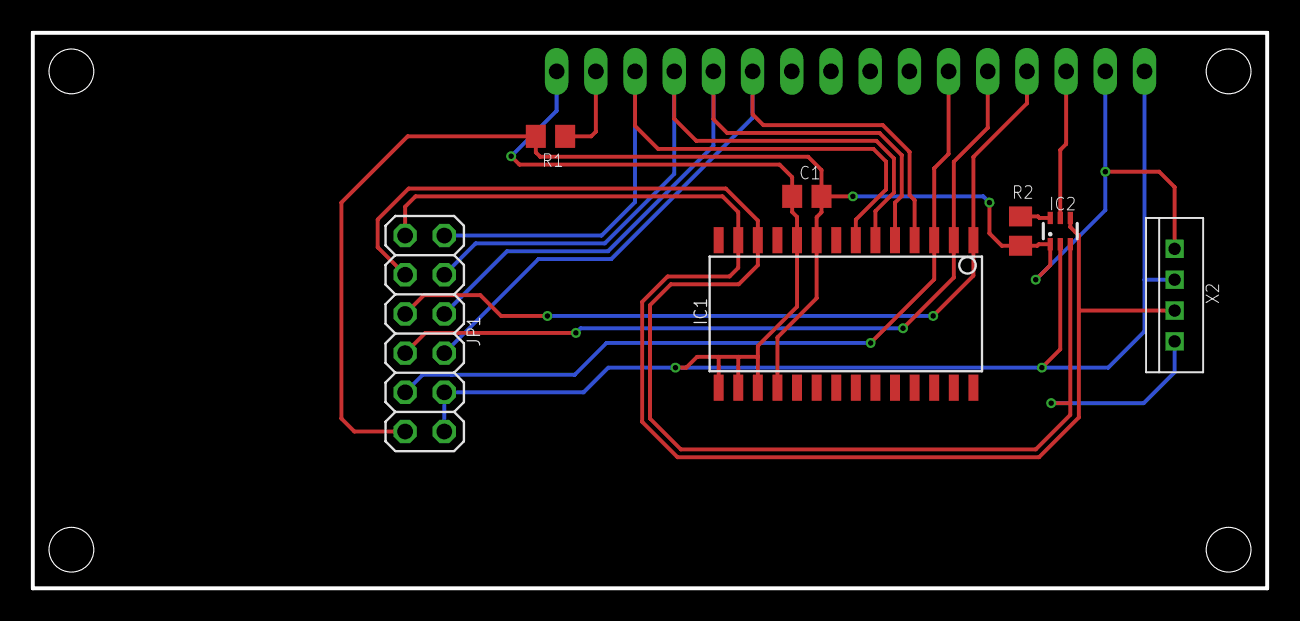
[picture p13: board display.brd from above]

Board: 2 copper layers, 80.0 x 36.0 mm, 8 parts (1 on the bottom side), 14 nets.
