sebabelz/SolderPi/pcb/encoder.brd

## EAGLE design pcb/encoder.brd (2018-05-15)

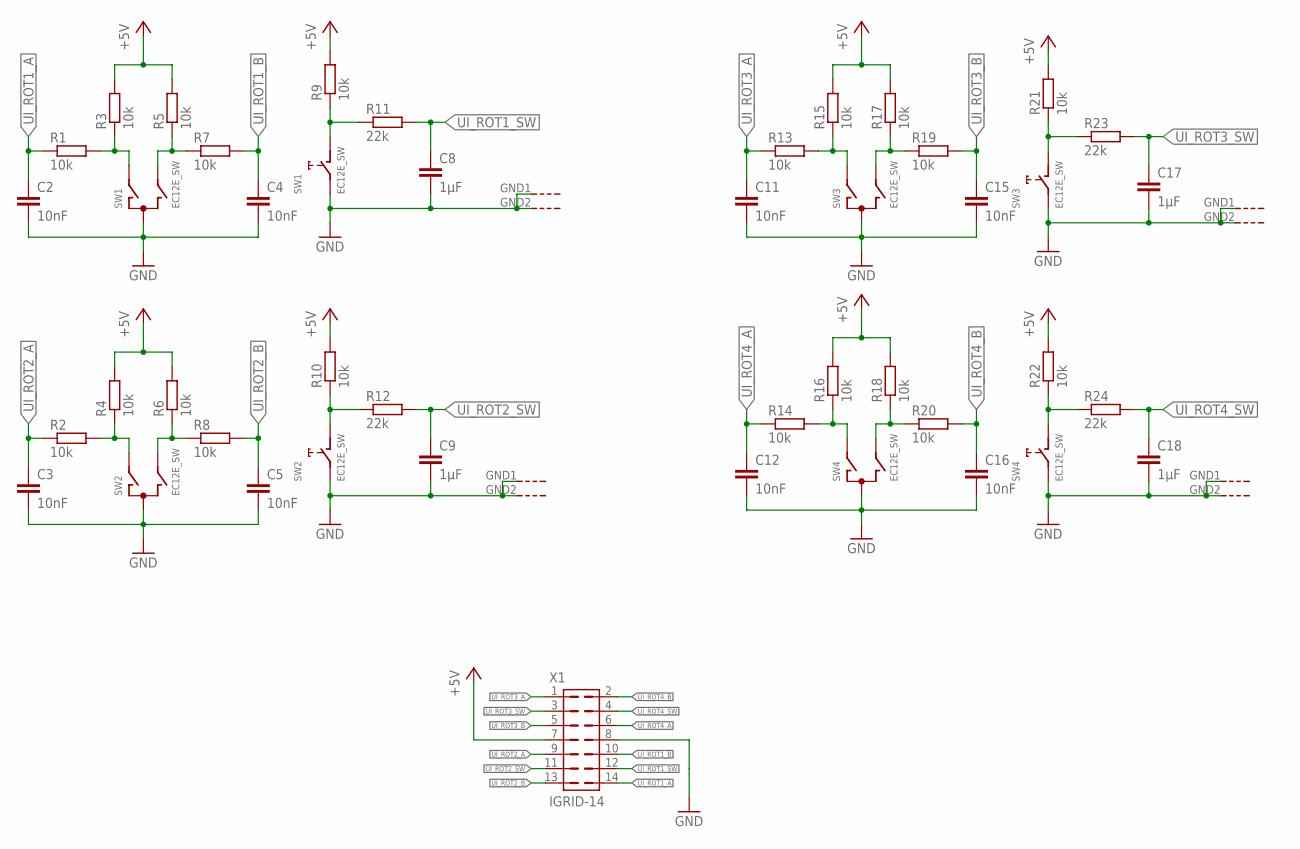
[picture p14: schematic encoder.sch]

Parts:
C2, C3, C4, C5, C11, C12, C15, C16: 10nF; C0805
C8, C9, C17, C18: 1µF; C0805
R1, R2, R3, R4, R5, R6, R7, R8, R9, R10, R13, R14, R15, R16, R17, R18, R19, R20, R21, R22: 10k; R0805
R11, R12, R23, R24: 22k; R0805
SW1, SW2, SW3, SW4: EC12E_SW; ALPS_EC12E_SW
X1: IGRID-14; I-GRID-14

Connections:
+5V: R3.2, R4.2, R5.2, R6.2, R9.2, R10.2, R15.2, R16.2, R17.2, R18.2, R21.2, R22.2, X1.7
GND: C2.2, C3.2, C4.2, C5.2, C8.2, C9.2, C11.2, C12.2, C15.2, C16.2, C17.2, C18.2, SW1.C, SW1.E (2), SW1.GND1 (G), SW1.GND2 (G), SW2.C, SW2.E (2), SW2.GND1 (G), SW2.GND2 (G), SW3.C, SW3.E (2), SW3.GND1 (G), SW3.GND2 (G), SW4.C, SW4.E (2), SW4.GND1 (G), SW4.GND2 (G), X1.8
UI_ROT1_A: C2.1, R1.1, X1.14
UI_ROT1_A_UNFIL: R1.2, R3.1, SW1.A
UI_ROT1_B: C4.1, R7.2, X1.10
UI_ROT1_B_UNFIL: R5.1, R7.1, SW1.B
UI_ROT1_SW: C8.1, R11.2, X1.12
UI_ROT1_SW_R: R9.1, R11.1, SW1.D (1)
UI_ROT2_A: C3.1, R2.1, X1.9
UI_ROT2_A_UNFIL: R2.2, R4.1, SW2.A
UI_ROT2_B: C5.1, R8.2, X1.13
UI_ROT2_B_UNFIL: R6.1, R8.1, SW2.B
UI_ROT2_SW: C9.1, R12.2, X1.11
UI_ROT2_SW_R: R10.1, R12.1, SW2.D (1)
UI_ROT3_A: C11.1, R13.1, X1.1
UI_ROT3_A_UNFIL: R13.2, R15.1, SW3.A
UI_ROT3_B: C15.1, R19.2, X1.5
UI_ROT3_B_UNFIL: R17.1, R19.1, SW3.B
UI_ROT3_SW: C17.1, R23.2, X1.3
UI_ROT3_SW_R: R21.1, R23.1, SW3.D (1)
UI_ROT4_A: C12.1, R14.1, X1.6
UI_ROT4_A_UNFIL: R14.2, R16.1, SW4.A
UI_ROT4_B: C16.1, R20.2, X1.2
UI_ROT4_B_UNFIL: R18.1, R20.1, SW4.B
UI_ROT4_SW: C18.1, R24.2, X1.4
UI_ROT4_SW_R: R22.1, R24.1, SW4.D (1)

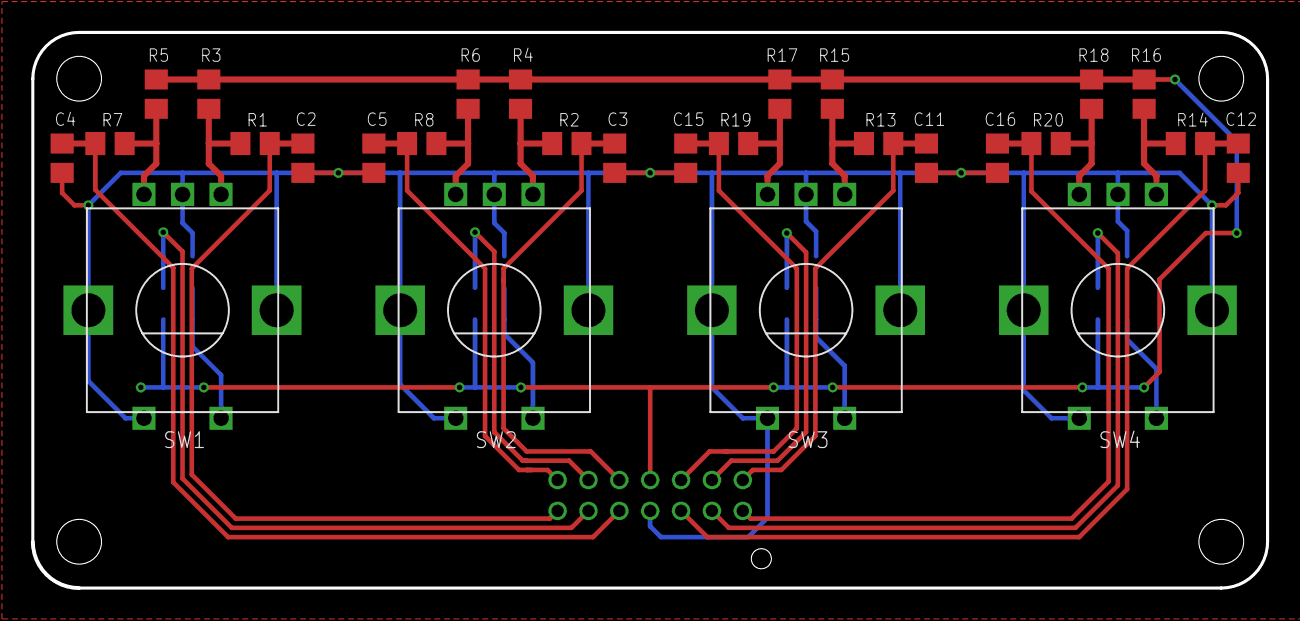
[picture p15: board encoder.brd from above]

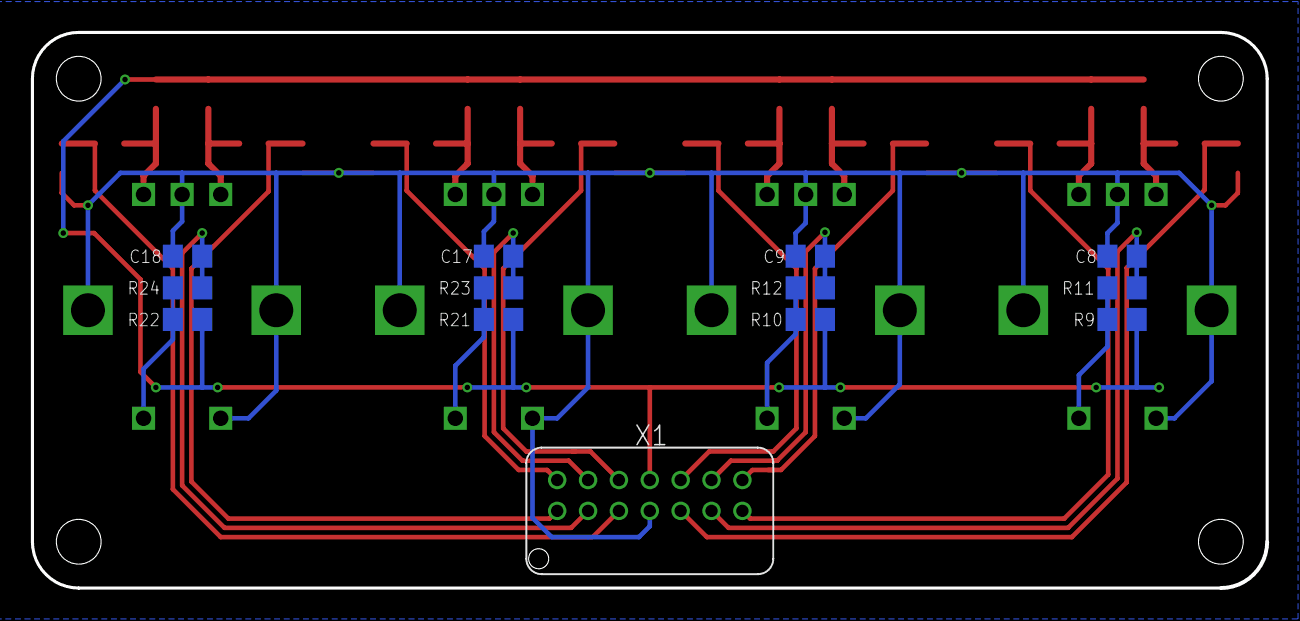
[picture p16: board encoder.brd from below]

Board: 2 copper layers, 80.0 x 36.0 mm, 41 parts (13 on the bottom side), 26 nets.
