sebabelz/SolderPi/pcb/controller.brd

## EAGLE design pcb/controller.brd (2018-05-15)

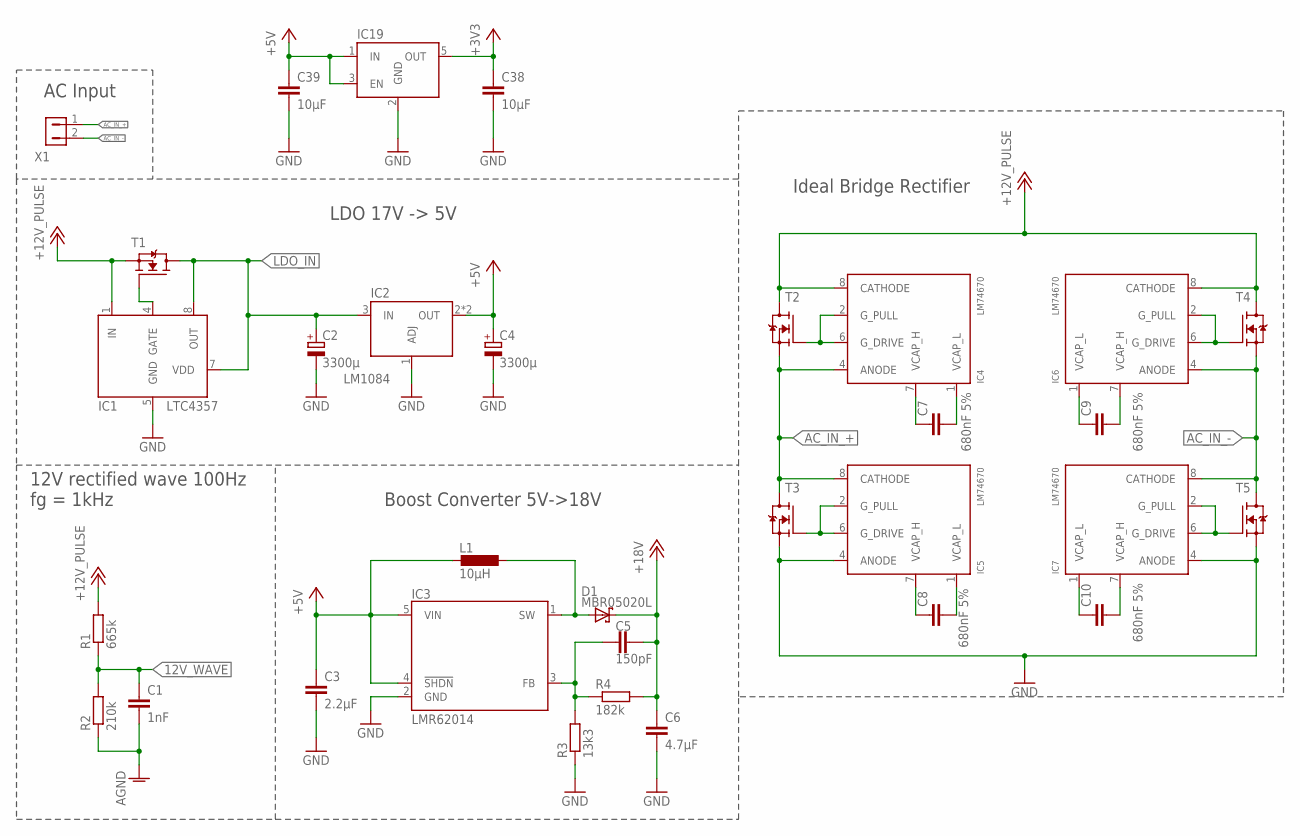
[picture p17: schematic controller.sch, sheet 1]

Parts:
C1: 1nF; C0603
C2, C4: 3300µ; C_EEVFK
C3: 2.2µF; C0805
C5: 150pF; C0805
C6: 4.7µF; C0805
C7, C8, C9, C10: 680nF 5%; C0805
C38, C39: 10µF; C0805
D1: MBR05020L; SOD-123
IC1: LTC4357; MSOP8
IC2: LM1084; TO263
IC3: LMR62014; SOT23-5L
IC4, IC5, IC6, IC7: LM74670; VSSOP-8
IC19: MIC5504; SOT23-5L
L1: 10µH; WE-TPC
R1: 665k; R0603
R2: 210k; R0603
R3: 13k3; R0805
R4: 182k; R0805
T1: FDS6670A; SO8
T2, T3, T4, T5: PSMN1R0; LFPAK56-5
X1: ULTRAFIT-20; ULTRAFIT-2

Connections:
12V_WAVE: C1.1, R1.1, R2.2; also elsewhere on the board
+3V3: C38.1, IC19.5 (OUT); also elsewhere on the board
+5V: C3.1, C4.+, C39.1, IC2.2 (OUT), IC2.4 (OUT), IC3.4 (!SHDN!), IC3.5 (VIN), IC19.1 (IN), IC19.3 (EN), L1.2; also elsewhere on the board
+12V_PULSE: IC1.1 (IN), IC4.8 (CATHODE), IC6.8 (CATHODE), R1.2, T1.1 (S), T1.2 (S), T1.3 (S), T2.5 (D), T4.5 (D); also elsewhere on the board
+18V: C5.1, C6.1, D1.1 (C), R4.2; also elsewhere on the board
AC_IN_+: IC4.4 (ANODE), IC5.8 (CATHODE), T2.1 (S), T2.2 (S), T2.3 (S), T3.5 (D), X1.1
AC_IN_-: IC6.4 (ANODE), IC7.8 (CATHODE), T4.1 (S), T4.2 (S), T4.3 (S), T5.5 (D), X1.2
AGND: C1.2, R2.1; also elsewhere on the board
BOOST_FB: C5.2, IC3.3 (FB), R3.2, R4.1
BOOST_SW: D1.2 (A), IC3.1 (SW), L1.1
DIODE_G: IC1.4 (GATE), T1.4 (G)
GND: C2.-, C3.2, C4.-, C6.2, C38.2, C39.2, IC1.5 (GND), IC2.1 (ADJ), IC3.2 (GND), IC5.4 (ANODE), IC7.4 (ANODE), IC19.2 (GND), R3.1, T3.1 (S), T3.2 (S), T3.3 (S), T5.1 (S), T5.2 (S), T5.3 (S); also elsewhere on the board
LDO_IN: C2.+, IC1.7 (VDD), IC1.8 (OUT), IC2.3 (IN), T1.5 (D), T1.6 (D), T1.7 (D), T1.8 (D)
RECT_D1_CAP_H1: C7.1, IC4.7 (VCAP_H)
RECT_D1_CAP_L1: C7.2, IC4.1 (VCAP_L)
RECT_D1_G1: IC4.2 (G_PULL), IC4.6 (G_DRIVE), T2.4 (G)
RECT_D2_CAP_H1: C9.2, IC6.1 (VCAP_L)
RECT_D2_CAP_L1: C9.1, IC6.7 (VCAP_H)
RECT_D2_G1: IC6.2 (G_PULL), IC6.6 (G_DRIVE), T4.4 (G)
RECT_D3_CAP_H1: C8.1, IC5.7 (VCAP_H)
RECT_D3_CAP_L1: C8.2, IC5.1 (VCAP_L)
RECT_D3_G1: IC5.2 (G_PULL), IC5.6 (G_DRIVE), T3.4 (G)
RECT_D4_CAP_H1: C10.2, IC7.1 (VCAP_L)
RECT_D4_CAP_L1: C10.1, IC7.7 (VCAP_H)
RECT_D4_G1: IC7.2 (G_PULL), IC7.6 (G_DRIVE), T5.4 (G)

Notes on the sheet:
AC Input
LDO 17V -> 5V
Ideal Bridge Rectifier
12V rectified wave 100Hz fg = 1kHz
Boost Converter 5V->18V

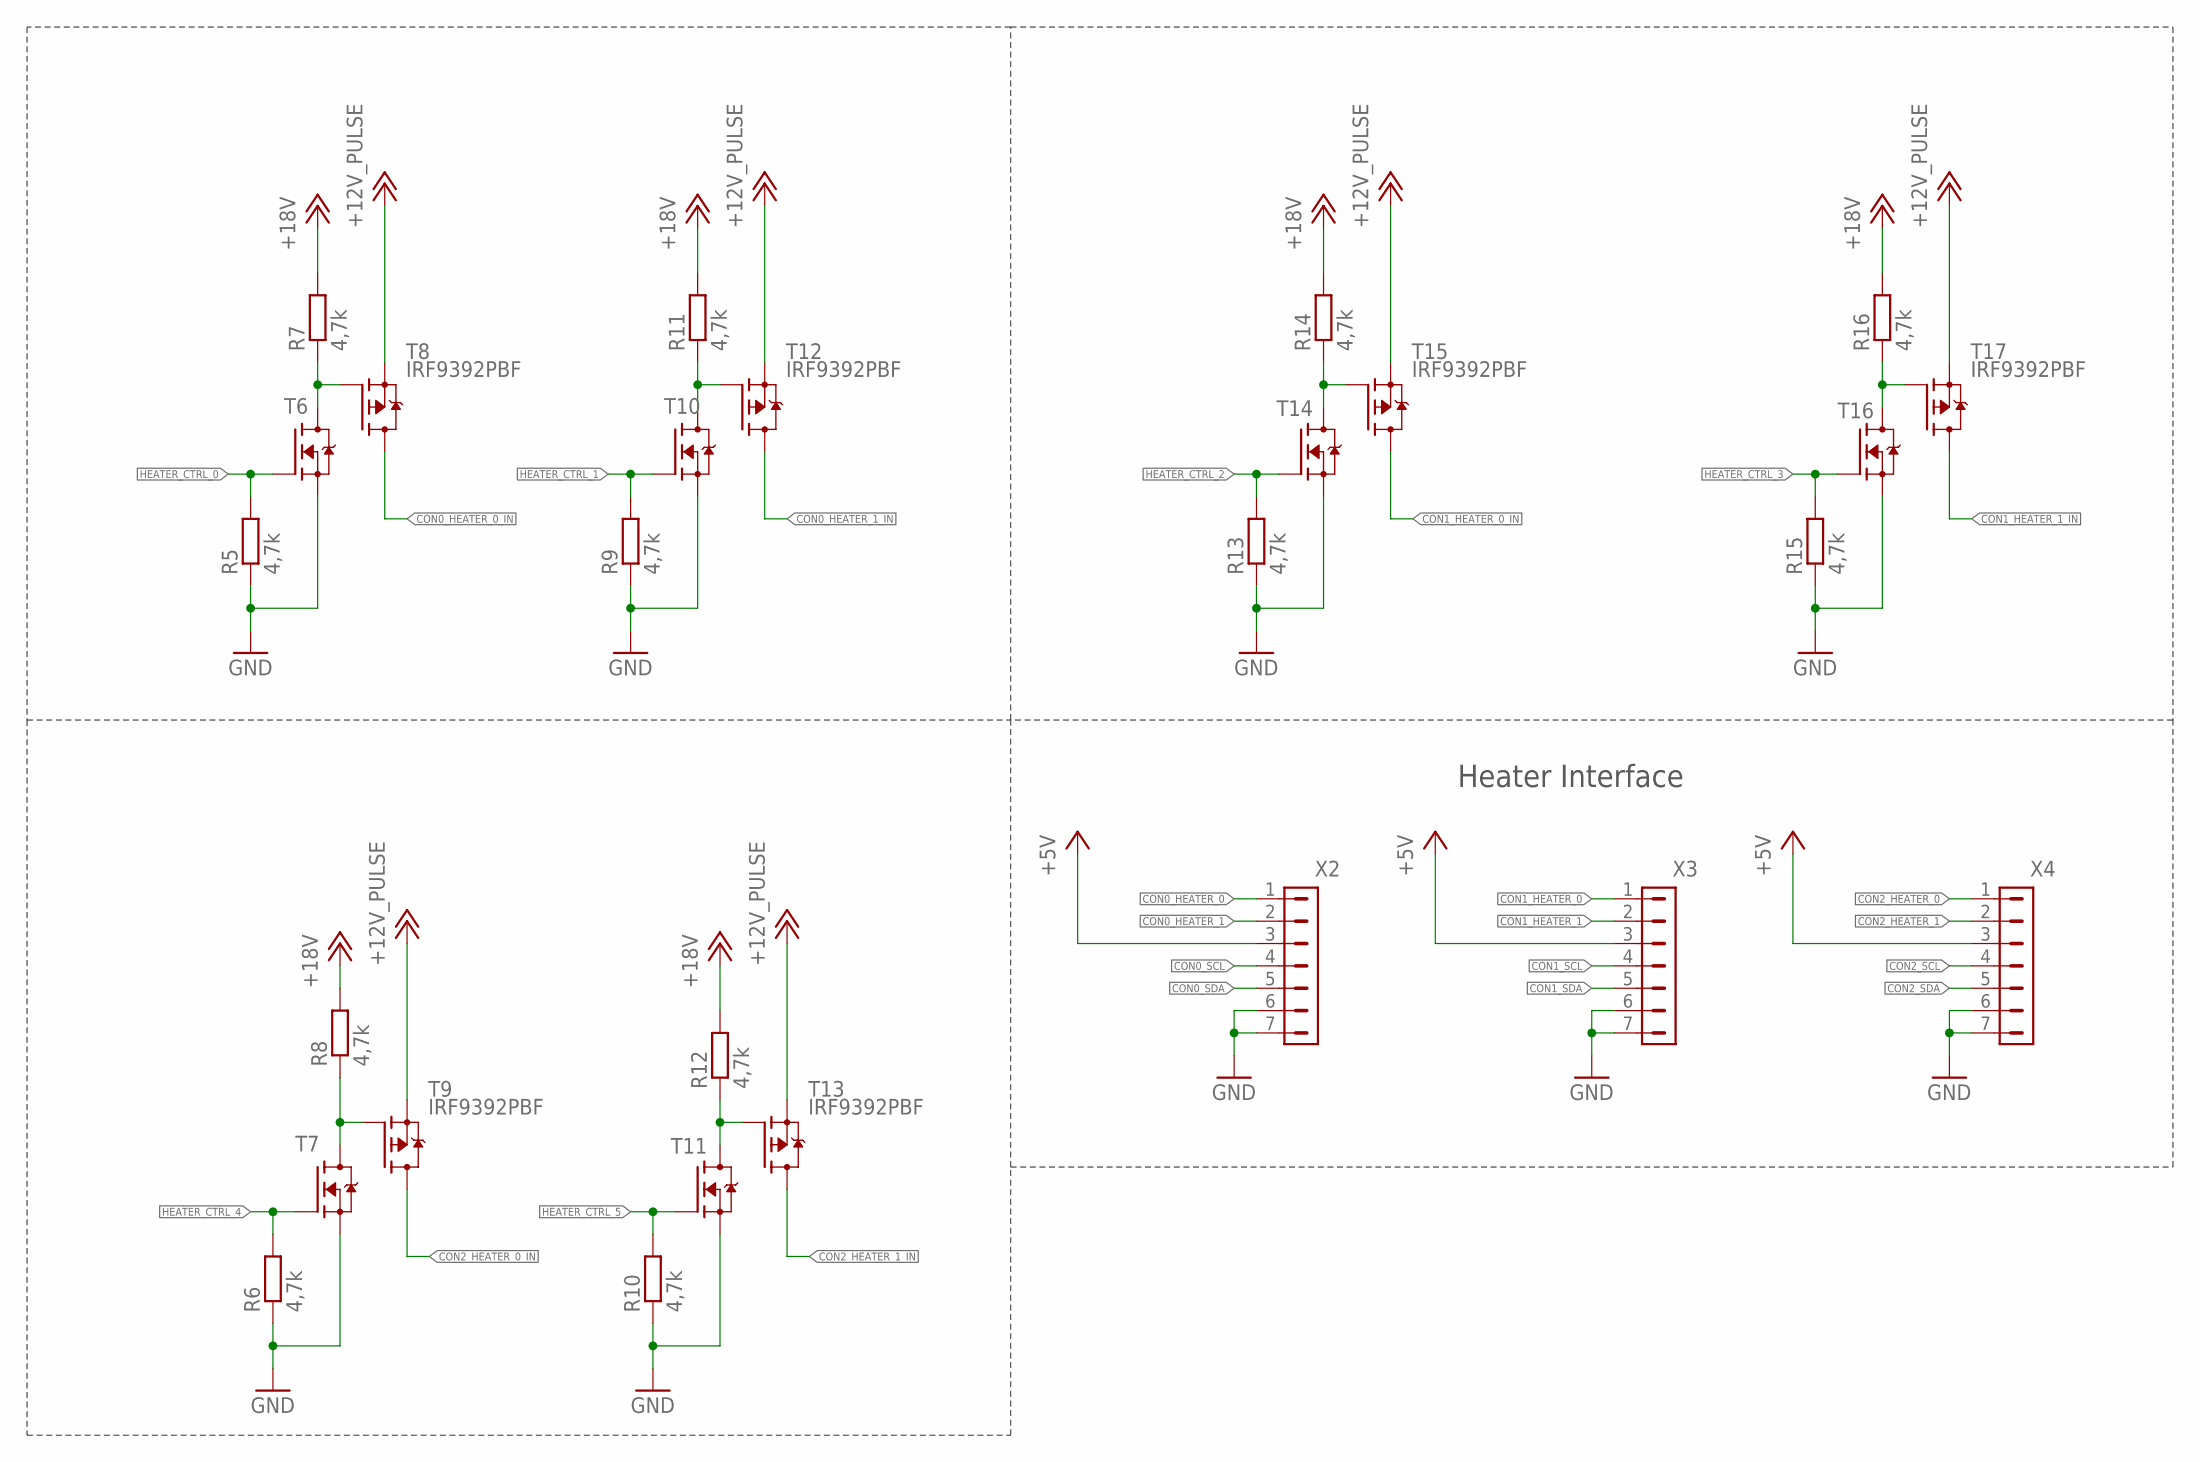
[picture p18: schematic controller.sch, sheet 2]

Parts:
R5, R6, R7, R8, R9, R10, R11, R12, R13, R14, R15, R16: 4,7k; R0805
T6, T7, T10, T11, T14, T16: NVR4003NT3G; SOT23
T8, T9, T12, T13, T15, T17: IRF9392PBF; SO8
X2, X3, X4: NANOFIT-7

Connections:
+5V: X2.3, X3.3, X4.3; also elsewhere on the board
+12V_PULSE: T8.1 (S), T8.2 (S), T8.3 (S), T9.1 (S), T9.2 (S), T9.3 (S), T12.1 (S), T12.2 (S), T12.3 (S), T13.1 (S), T13.2 (S), T13.3 (S), T15.1 (S), T15.2 (S), T15.3 (S), T17.1 (S), T17.2 (S), T17.3 (S); also elsewhere on the board
+18V: R7.2, R8.2, R11.2, R12.2, R14.2, R16.2; also elsewhere on the board
CON0_HEATER_0: X2.1; also elsewhere on the board
CON0_HEATER_0_IN: T8.5 (D), T8.6 (D), T8.7 (D), T8.8 (D); also elsewhere on the board
CON0_HEATER_1: X2.2; also elsewhere on the board
CON0_HEATER_1_IN: T12.5 (D), T12.6 (D), T12.7 (D), T12.8 (D); also elsewhere on the board
CON0_SCL: X2.4; also elsewhere on the board
CON0_SDA: X2.5; also elsewhere on the board
CON1_HEATER_0: X3.1; also elsewhere on the board
CON1_HEATER_0_IN: T15.5 (D), T15.6 (D), T15.7 (D), T15.8 (D); also elsewhere on the board
CON1_HEATER_1: X3.2; also elsewhere on the board
CON1_HEATER_1_IN: T17.5 (D), T17.6 (D), T17.7 (D), T17.8 (D); also elsewhere on the board
CON1_SCL: X3.4; also elsewhere on the board
CON1_SDA: X3.5; also elsewhere on the board
CON2_HEATER_0: X4.1; also elsewhere on the board
CON2_HEATER_0_IN: T9.5 (D), T9.6 (D), T9.7 (D), T9.8 (D); also elsewhere on the board
CON2_HEATER_1: X4.2; also elsewhere on the board
CON2_HEATER_1_IN: T13.5 (D), T13.6 (D), T13.7 (D), T13.8 (D); also elsewhere on the board
CON2_SCL: X4.4; also elsewhere on the board
CON2_SDA: X4.5; also elsewhere on the board
GND: R5.1, R6.1, R9.1, R10.1, R13.1, R15.1, T6.2 (S), T7.2 (S), T10.2 (S), T11.2 (S), T14.2 (S), T16.2 (S), X2.6, X2.7, X3.6, X3.7, X4.6, X4.7; also elsewhere on the board
HEATER0_G0: R7.1, T6.3 (D), T8.4 (G)
HEATER0_G1: R11.1, T10.3 (D), T12.4 (G)
HEATER1_G0: R14.1, T14.3 (D), T15.4 (G)
HEATER1_G1: R16.1, T16.3 (D), T17.4 (G)
HEATER2_G0: R8.1, T7.3 (D), T9.4 (G)
HEATER2_G1: R12.1, T11.3 (D), T13.4 (G)
HEATER_CTRL_0: R5.2, T6.1 (G); also elsewhere on the board
HEATER_CTRL_1: R9.2, T10.1 (G); also elsewhere on the board
HEATER_CTRL_2: R13.2, T14.1 (G); also elsewhere on the board
HEATER_CTRL_3: R15.2, T16.1 (G); also elsewhere on the board
HEATER_CTRL_4: R6.2, T7.1 (G); also elsewhere on the board
HEATER_CTRL_5: R10.2, T11.1 (G); also elsewhere on the board

Notes on the sheet:
Heater Interface

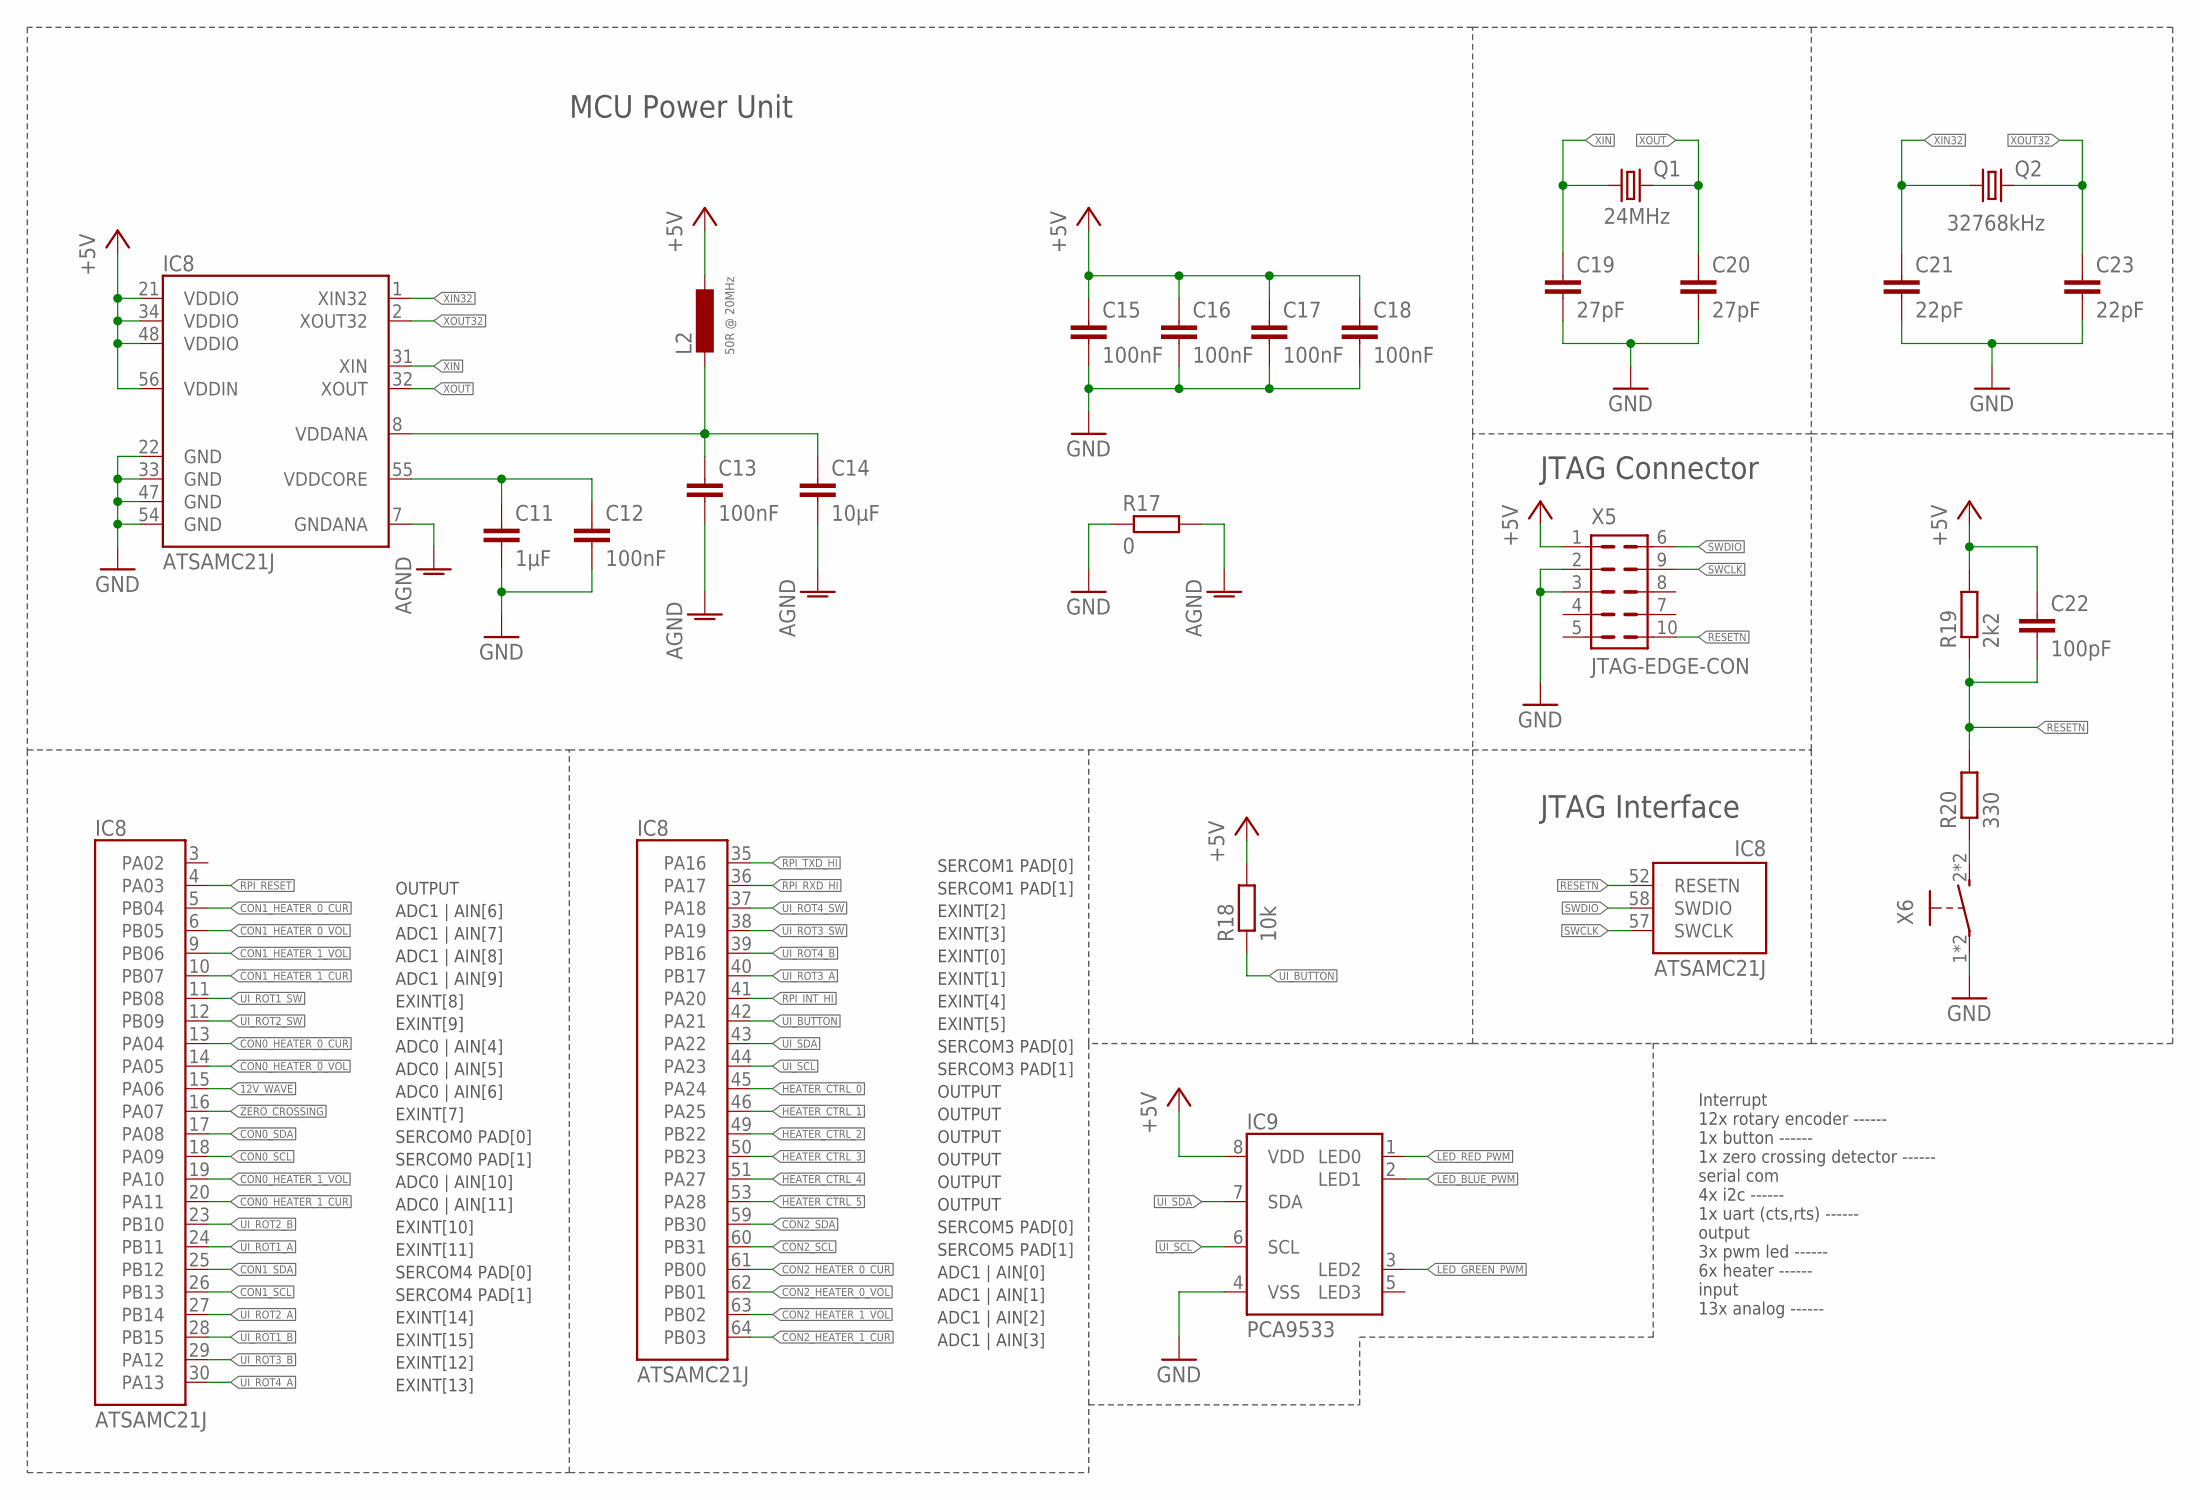
[picture p19: schematic controller.sch, sheet 3]

Parts:
C11: 1µF; C0402
C12, C13, C15, C16, C17, C18: 100nF; C0402
C14: 10µF; C0805
C19, C20: 27pF; C0402
C21, C23: 22pF; C0402
C22: 100pF; C0603
IC8: ATSAMC21J; TQFP64-10X10
IC9: PCA9533; TSSOP8
L2: 50R @ 20MHz; L0603
Q1: 24MHz; 5X3.2
Q2: 32768kHz; 2X1.2
R17: 0; R1210
R18: 10k; R0603
R19: 2k2; R0603
R20: 330; R0603
X5: JTAG-EDGE-CON; DEBUG-CON
X6: B3S-1000; B3S

Connections:
12V_WAVE: IC8.15 (PA06); also elsewhere on the board
+5V: C15.1, C16.1, C17.1, C18.1, C22.1, IC8.21 (VDDIO), IC8.34 (VDDIO), IC8.48 (VDDIO), IC8.56 (VDDIN), IC9.8 (VDD), L2.1, R18.2, R19.2, X5.1; also elsewhere on the board
AGND: C13.2, C14.2, IC8.7 (GNDANA), R17.2; also elsewhere on the board
CON0_HEATER_0_CUR: IC8.13 (PA04); also elsewhere on the board
CON0_HEATER_0_VOL: IC8.14 (PA05); also elsewhere on the board
CON0_HEATER_1_CUR: IC8.20 (PA11); also elsewhere on the board
CON0_HEATER_1_VOL: IC8.19 (PA10); also elsewhere on the board
CON0_SCL: IC8.18 (PA09); also elsewhere on the board
CON0_SDA: IC8.17 (PA08); also elsewhere on the board
CON1_HEATER_0_CUR: IC8.5 (PB04); also elsewhere on the board
CON1_HEATER_0_VOL: IC8.6 (PB05); also elsewhere on the board
CON1_HEATER_1_CUR: IC8.10 (PB07); also elsewhere on the board
CON1_HEATER_1_VOL: IC8.9 (PB06); also elsewhere on the board
CON1_SCL: IC8.26 (PB13); also elsewhere on the board
CON1_SDA: IC8.25 (PB12); also elsewhere on the board
CON2_HEATER_0_CUR: IC8.61 (PB00); also elsewhere on the board
CON2_HEATER_0_VOL: IC8.62 (PB01); also elsewhere on the board
CON2_HEATER_1_CUR: IC8.64 (PB03); also elsewhere on the board
CON2_HEATER_1_VOL: IC8.63 (PB02); also elsewhere on the board
CON2_SCL: IC8.60 (PB31); also elsewhere on the board
CON2_SDA: IC8.59 (PB30); also elsewhere on the board
GND: C11.2, C12.2, C15.2, C16.2, C17.2, C18.2, C19.2, C20.2, C21.2, C23.2, IC8.22 (GND), IC8.33 (GND), IC8.47 (GND), IC8.54 (GND), IC9.4 (VSS), R17.1, X5.2, X5.3, X6.1, X6.3; also elsewhere on the board
HEATER_CTRL_0: IC8.45 (PA24); also elsewhere on the board
HEATER_CTRL_1: IC8.46 (PA25); also elsewhere on the board
HEATER_CTRL_2: IC8.49 (PB22); also elsewhere on the board
HEATER_CTRL_3: IC8.50 (PB23); also elsewhere on the board
HEATER_CTRL_4: IC8.51 (PA27); also elsewhere on the board
HEATER_CTRL_5: IC8.53 (PA28); also elsewhere on the board
LED_BLUE_PWM: IC9.2 (LED1); also elsewhere on the board
LED_GREEN_PWM: IC9.3 (LED2); also elsewhere on the board
LED_RED_PWM: IC9.1 (LED0); also elsewhere on the board
RESETN: C22.2, IC8.52 (RESETN), R19.1, R20.2, X5.10; also elsewhere on the board
RESET_SW_IN: R20.1, X6.2 (S), X6.4 (S)
RPI_INT_HI: IC8.41 (PA20); also elsewhere on the board
RPI_RESET: IC8.4 (PA03); also elsewhere on the board
RPI_RXD_HI: IC8.36 (PA17); also elsewhere on the board
RPI_TXD_HI: IC8.35 (PA16); also elsewhere on the board
SWCLK: IC8.57 (SWCLK), X5.9; also elsewhere on the board
SWDIO: IC8.58 (SWDIO), X5.6; also elsewhere on the board
UI_BUTTON: IC8.42 (PA21), R18.1; also elsewhere on the board
UI_ROT1_A: IC8.24 (PB11); also elsewhere on the board
UI_ROT1_B: IC8.28 (PB15); also elsewhere on the board
UI_ROT1_SW: IC8.11 (PB08); also elsewhere on the board
UI_ROT2_A: IC8.27 (PB14); also elsewhere on the board
UI_ROT2_B: IC8.23 (PB10); also elsewhere on the board
UI_ROT2_SW: IC8.12 (PB09); also elsewhere on the board
UI_ROT3_A: IC8.40 (PB17); also elsewhere on the board
UI_ROT3_B: IC8.29 (PA12); also elsewhere on the board
UI_ROT3_SW: IC8.38 (PA19); also elsewhere on the board
UI_ROT4_A: IC8.30 (PA13); also elsewhere on the board
UI_ROT4_B: IC8.39 (PB16); also elsewhere on the board
UI_ROT4_SW: IC8.37 (PA18); also elsewhere on the board
UI_SCL: IC8.44 (PA23), IC9.6 (SCL); also elsewhere on the board
UI_SDA: IC8.43 (PA22), IC9.7 (SDA); also elsewhere on the board
VDDANA: C13.1, C14.1, IC8.8 (VDDANA), L2.2
VDDCORE: C11.1, C12.1, IC8.55 (VDDCORE)
XIN: C19.1, IC8.31 (XIN), Q1.1
XIN32: C21.1, IC8.1 (XIN32), Q2.1
XOUT: C20.1, IC8.32 (XOUT), Q1.2
XOUT32: C23.1, IC8.2 (XOUT32), Q2.2
ZERO_CROSSING: IC8.16 (PA07); also elsewhere on the board

Notes on the sheet:
Interrupt 12x rotary encoder ------ 1x button ------ 1x zero crossing detector ------ serial com 4x i2c ------ 1x uart (cts,rts) ------ output 3x pwm led ------ 6x heater ------ input 13x analog ------
JTAG Interface
JTAG Connector
MCU Power Unit
ADC1 | AIN[9]
ADC1 | AIN[8]
ADC1 | AIN[7]
ADC1 | AIN[6]
ADC0 | AIN[4]
ADC0 | AIN[5]
ADC0 | AIN[6]
EXINT[7]
EXINT[9]
EXINT[8]
SERCOM0 PAD[1]
SERCOM0 PAD[0]
OUTPUT
ADC0 | AIN[10]
ADC0 | AIN[11]
EXINT[10]
EXINT[11]
EXINT[14]
EXINT[15]
EXINT[12]
EXINT[13]
SERCOM4 PAD[1]
SERCOM4 PAD[0]
ADC1 | AIN[0]
ADC1 | AIN[1]
ADC1 | AIN[2]
ADC1 | AIN[3]
SERCOM5 PAD[1]
SERCOM5 PAD[0]
SERCOM3 PAD[1]
SERCOM3 PAD[0]
SERCOM1 PAD[1]
SERCOM1 PAD[0]
EXINT[2]
EXINT[3]
EXINT[0]
EXINT[1]
EXINT[4]
EXINT[5]

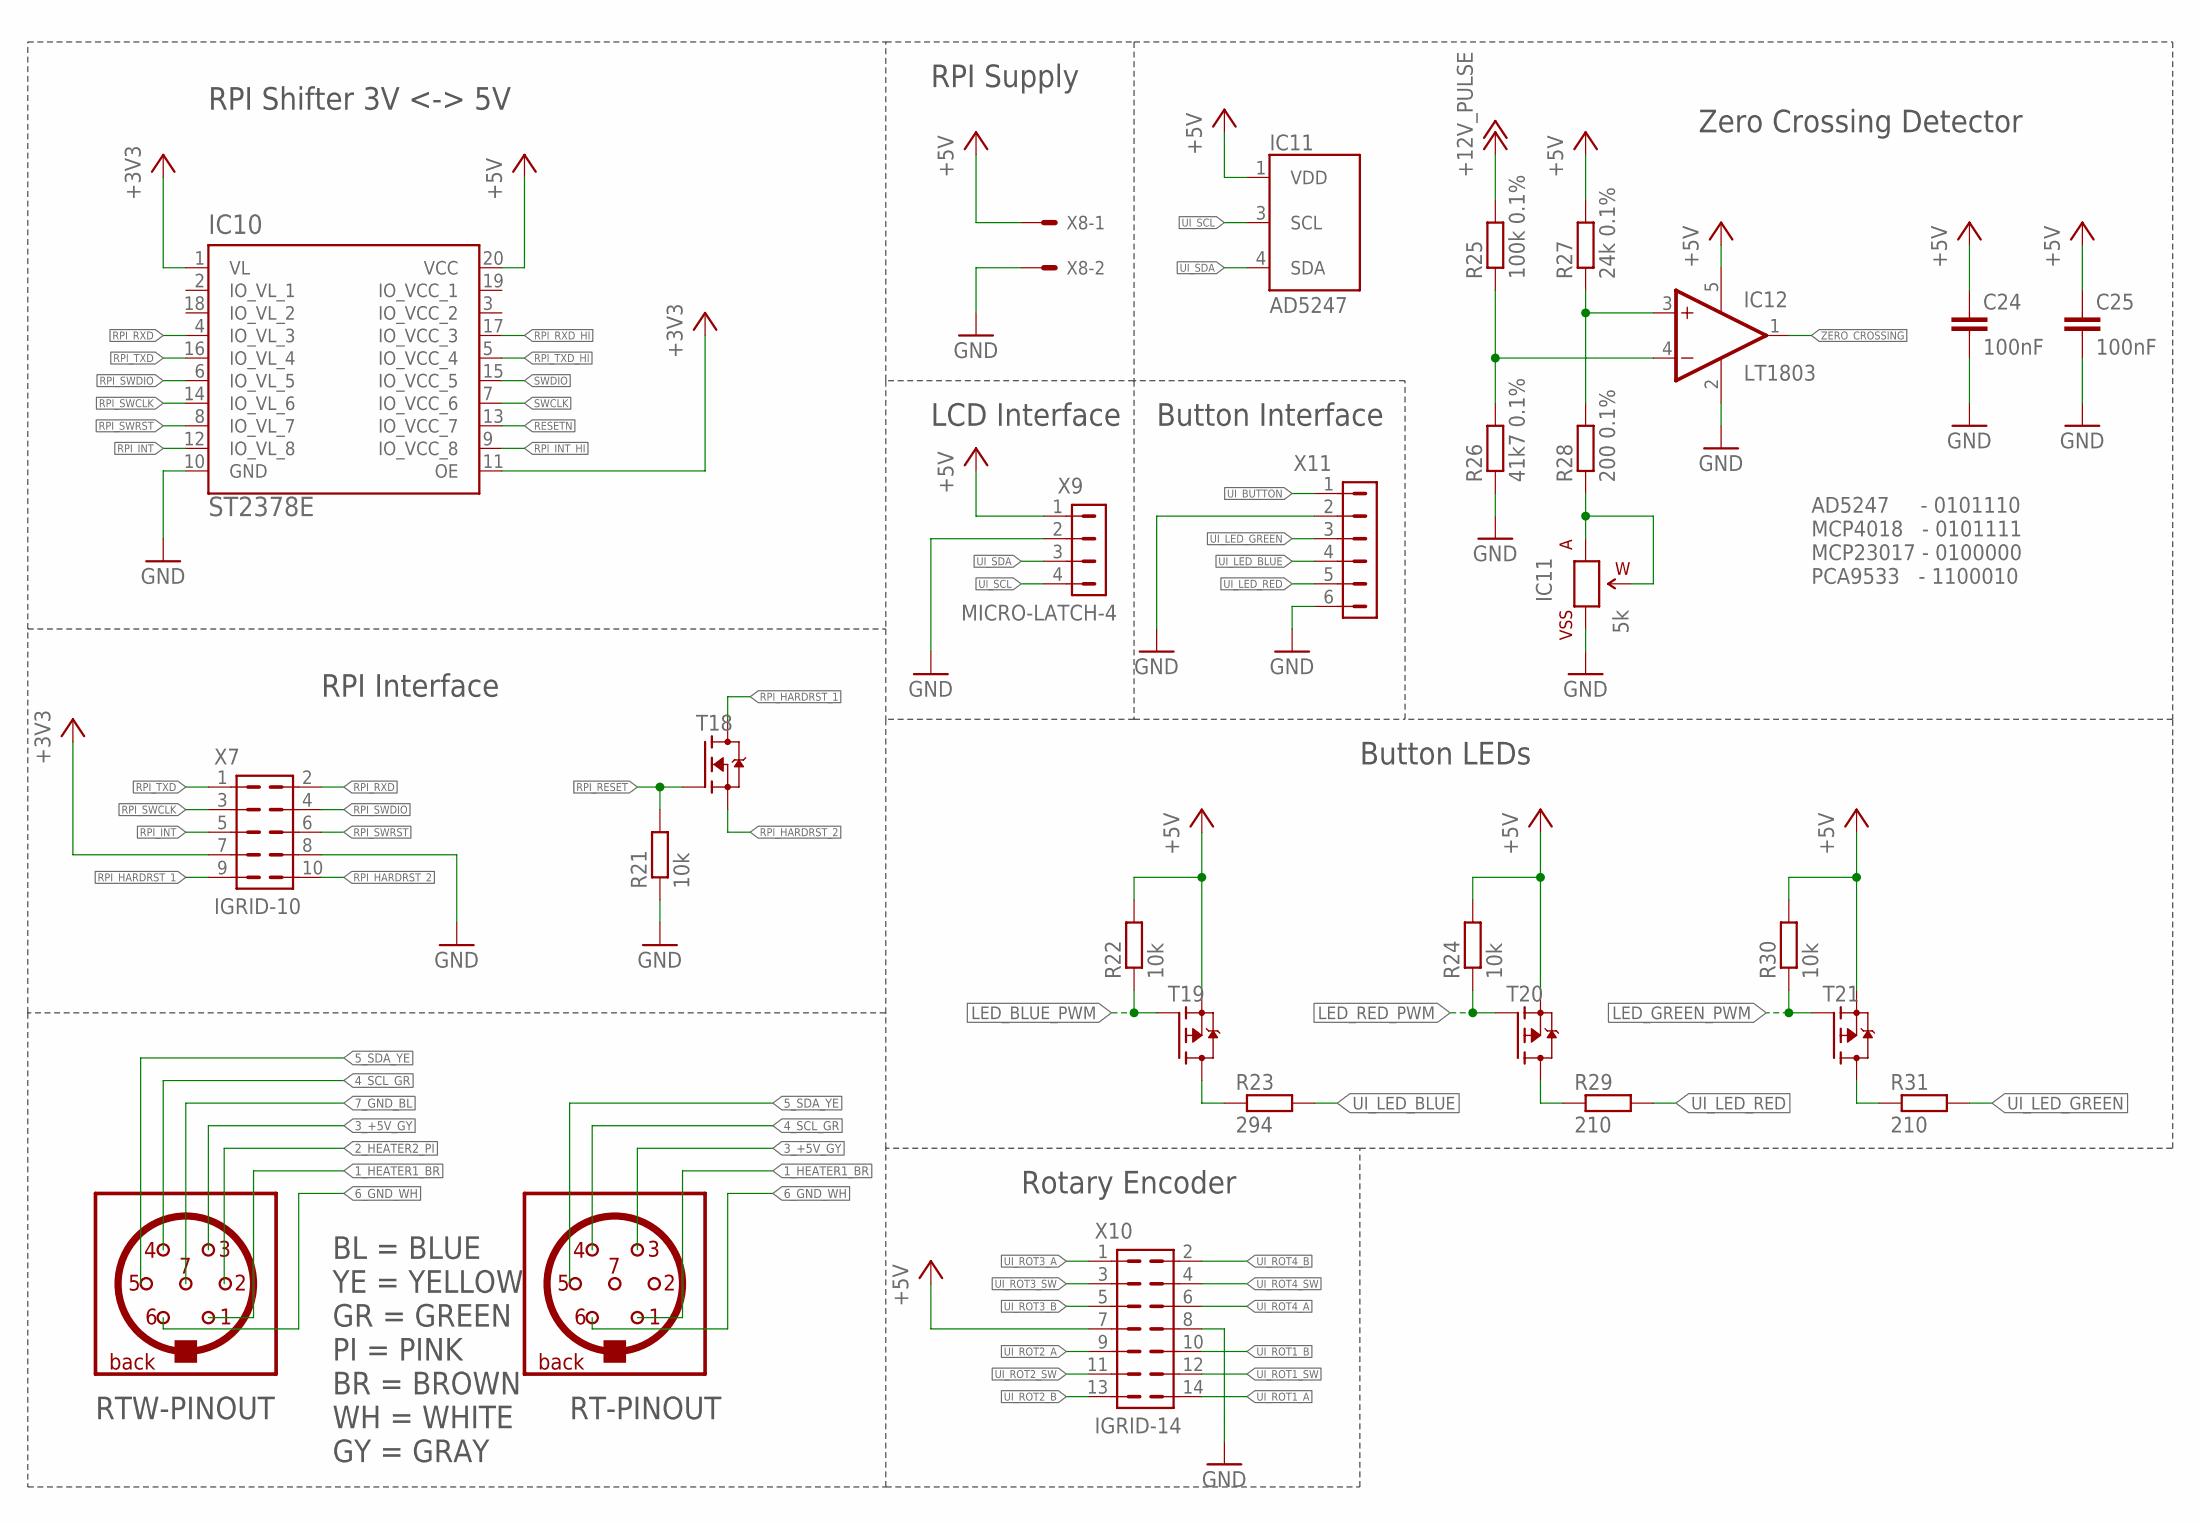
[picture p20: schematic controller.sch, sheet 4]

Parts:
C24, C25: 100nF; C0603
IC10: ST2378E; TSSOP20
IC11: 5k; SC70-6L
IC12: LT1803; SOT23-5L
R21, R22, R24, R30: 10k; R0603
R23: 294; R0805
R25: 100k 0.1%; R0603
R26: 41k7 0.1%; R0603
R27: 24k 0.1%; R0603
R28: 200 0.1%; R0603
R29, R31: 210; R0805
T18: BSS7728NH6327XTSA1; SOT23
T19, T20, T21: BSS84PH6433XTMA1; SOT23
X7: IGRID-10; I-GRID-10
X8: KK-156-2
X9: MICRO-LATCH-4
X10: IGRID-14; I-GRID-14
X11: MICRO-CLASP-6

Connections:
+3V3: IC10.1 (VL), IC10.11 (OE), X7.7; also elsewhere on the board
+5V: C24.1, C25.1, IC10.20 (VCC), IC11.1 (VDD), IC12.5 (V+), R22.2, R24.2, R27.2, R30.2, T19.2 (S), T20.2 (S), T21.2 (S), X8.1, X9.1, X10.7; also elsewhere on the board
+12V_PULSE: R25.2; also elsewhere on the board
GND: C24.2, C25.2, IC10.10 (GND), IC11.2 (VSS), IC12.2 (V-), R21.1, R26.1, X7.8, X8.2, X9.2, X10.8, X11.2, X11.6; also elsewhere on the board
LED_BLUE_D: R23.1, T19.3 (D)
LED_BLUE_PWM: R22.1, T19.1 (G); also elsewhere on the board
LED_GREEN_D: R31.1, T21.3 (D)
LED_GREEN_PWM: R30.1, T21.1 (G); also elsewhere on the board
LED_RED_D: R29.1, T20.3 (D)
LED_RED_PWM: R24.1, T20.1 (G); also elsewhere on the board
RESETN: IC10.13 (IO_VCC_7); also elsewhere on the board
RPI_HARDRST_1: T18.3 (D), X7.9
RPI_HARDRST_2: T18.2 (S), X7.10
RPI_INT: IC10.12 (IO_VL_8), X7.5
RPI_INT_HI: IC10.9 (IO_VCC_8); also elsewhere on the board
RPI_RESET: R21.2, T18.1 (G); also elsewhere on the board
RPI_RXD: IC10.4 (IO_VL_3), X7.2; also elsewhere on the board
RPI_RXD_HI: IC10.17 (IO_VCC_3); also elsewhere on the board
RPI_SWCLK: IC10.14 (IO_VL_6), X7.3
RPI_SWDIO: IC10.6 (IO_VL_5), X7.4
RPI_SWRST: IC10.8 (IO_VL_7), X7.6
RPI_TXD: IC10.16 (IO_VL_4), X7.1; also elsewhere on the board
RPI_TXD_HI: IC10.5 (IO_VCC_4); also elsewhere on the board
SWCLK: IC10.7 (IO_VCC_6); also elsewhere on the board
SWDIO: IC10.15 (IO_VCC_5); also elsewhere on the board
UI_BUTTON: X11.1; also elsewhere on the board
UI_LED_BLUE: R23.2, X11.4
UI_LED_GREEN: R31.2, X11.3
UI_LED_RED: R29.2, X11.5
UI_ROT1_A: X10.14; also elsewhere on the board
UI_ROT1_B: X10.10; also elsewhere on the board
UI_ROT1_SW: X10.12; also elsewhere on the board
UI_ROT2_A: X10.9; also elsewhere on the board
UI_ROT2_B: X10.13; also elsewhere on the board
UI_ROT2_SW: X10.11; also elsewhere on the board
UI_ROT3_A: X10.1; also elsewhere on the board
UI_ROT3_B: X10.5; also elsewhere on the board
UI_ROT3_SW: X10.3; also elsewhere on the board
UI_ROT4_A: X10.6; also elsewhere on the board
UI_ROT4_B: X10.2; also elsewhere on the board
UI_ROT4_SW: X10.4; also elsewhere on the board
UI_SCL: IC11.3 (SCL), X9.4; also elsewhere on the board
UI_SDA: IC11.4 (SDA), X9.3; also elsewhere on the board
ZC_ADJ: IC11.5 (W), IC11.6 (A), R28.1
ZC_IN+: IC12.3 (+IN), R27.1, R28.2
ZC_IN+-: IC12.4 (-IN), R25.1, R26.2
ZERO_CROSSING: IC12.1 (OUT); also elsewhere on the board

Notes on the sheet:
BL = BLUE YE = YELLOW GR = GREEN PI = PINK BR = BROWN WH = WHITE GY = GRAY
RTW-PINOUT
RT-PINOUT
RPI Supply
RPI Interface
RPI Shifter 3V <-> 5V
LCD Interface
Rotary Encoder
Button Interface
Button LEDs
Zero Crossing Detector
AD5247
AD5247 - 0101110 MCP4018 - 0101111 MCP23017 - 0100000 PCA9533 - 1100010
