sebabelz/SolderPi/pcb/controller.brd

## EAGLE design pcb/controller.brd (continued)

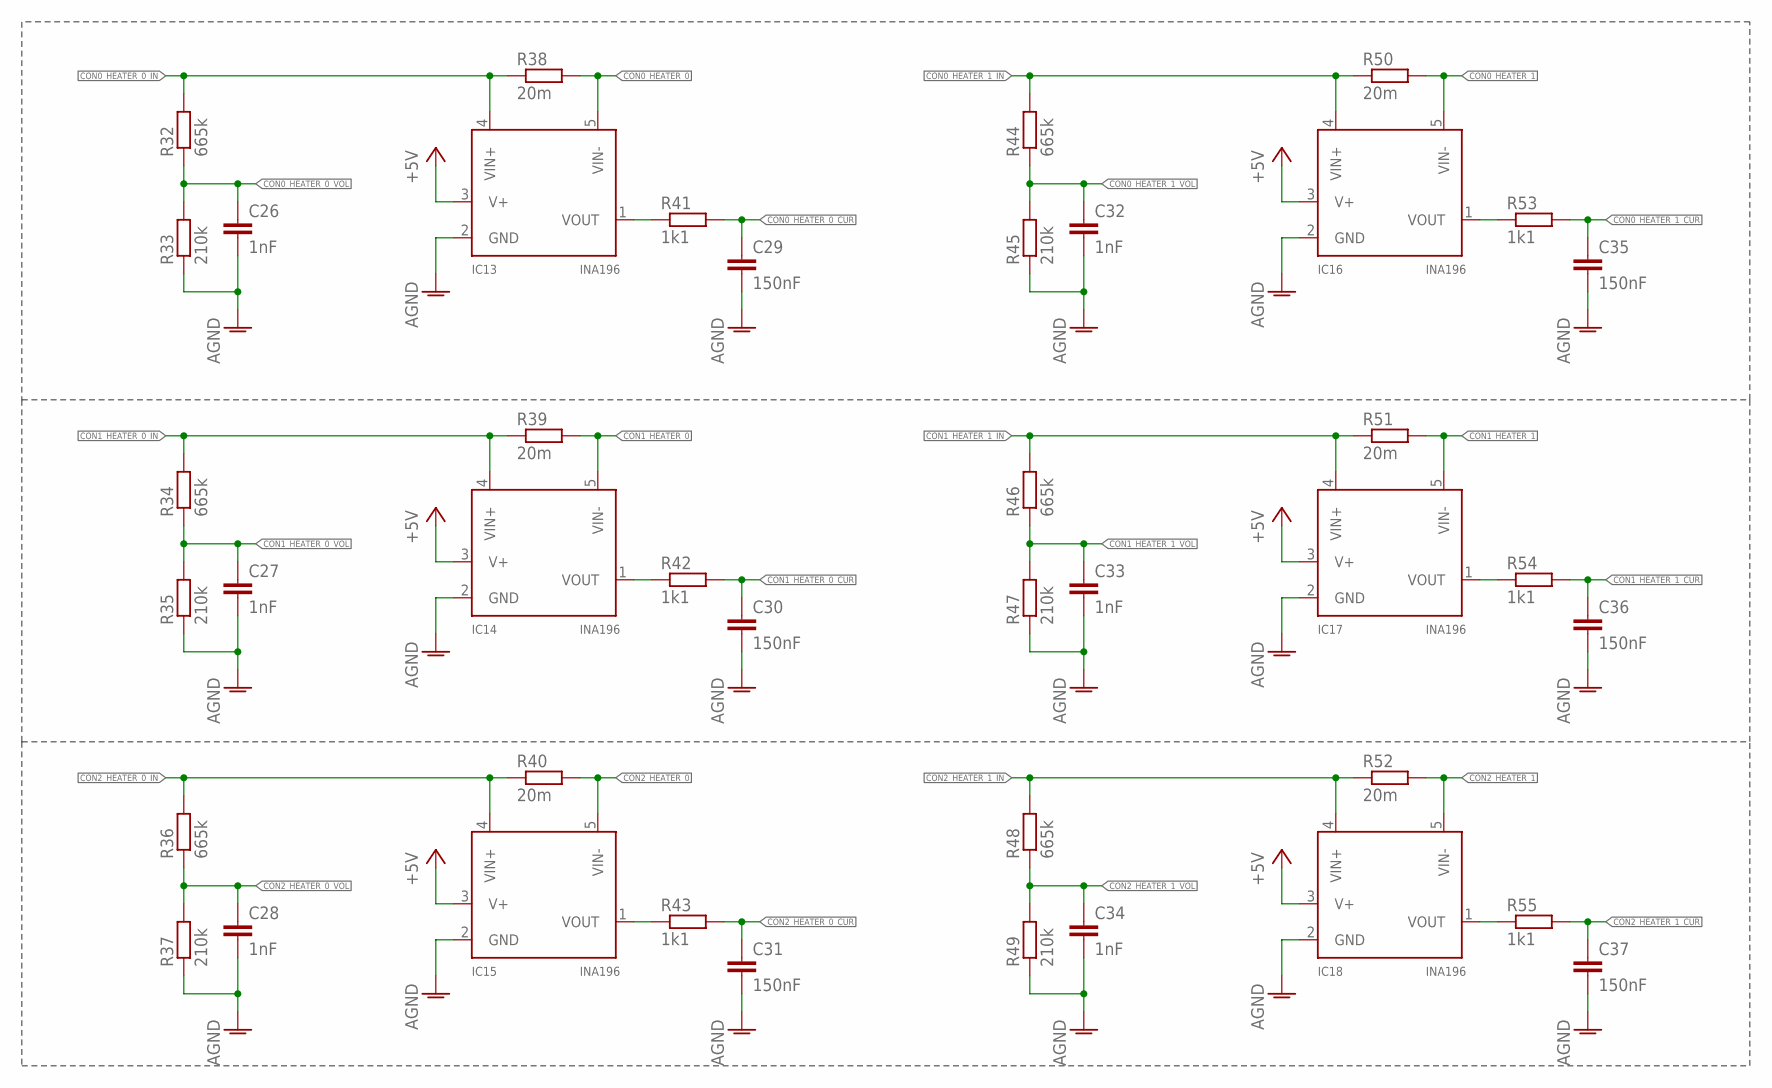
[picture p21: schematic controller.sch, sheet 5]

Parts:
C26, C27, C28, C32, C33, C34: 1nF; C0603
C29, C30, C31, C35, C36, C37: 150nF; C0603
IC13, IC14, IC15, IC16, IC17, IC18: INA196; SOT23-5L
R32, R34, R36, R44, R46, R48: 665k; R0603
R33, R35, R37, R45, R47, R49: 210k; R0603
R38, R39, R40, R50, R51, R52: 20m; R1206
R41, R42, R43, R53, R54, R55: 1k1; R0603

Connections:
+5V: IC13.3 (V+), IC14.3 (V+), IC15.3 (V+), IC16.3 (V+), IC17.3 (V+), IC18.3 (V+); also elsewhere on the board
AGND: C26.2, C27.2, C28.2, C29.2, C30.2, C31.2, C32.2, C33.2, C34.2, C35.2, C36.2, C37.2, IC13.2 (GND), IC14.2 (GND), IC15.2 (GND), IC16.2 (GND), IC17.2 (GND), IC18.2 (GND), R33.1, R35.1, R37.1, R45.1, R47.1, R49.1; also elsewhere on the board
CON0_HEATER_0: IC13.5 (VIN-), R38.2; also elsewhere on the board
CON0_HEATER_0_CUR: C29.1, R41.2; also elsewhere on the board
CON0_HEATER_0_IN: IC13.4 (VIN+), R32.2, R38.1; also elsewhere on the board
CON0_HEATER_0_VOL: C26.1, R32.1, R33.2; also elsewhere on the board
CON0_HEATER_1: IC16.5 (VIN-), R50.2; also elsewhere on the board
CON0_HEATER_1_CUR: C35.1, R53.2; also elsewhere on the board
CON0_HEATER_1_IN: IC16.4 (VIN+), R44.2, R50.1; also elsewhere on the board
CON0_HEATER_1_VOL: C32.1, R44.1, R45.2; also elsewhere on the board
CON1_HEATER_0: IC14.5 (VIN-), R39.2; also elsewhere on the board
CON1_HEATER_0_CUR: C30.1, R42.2; also elsewhere on the board
CON1_HEATER_0_IN: IC14.4 (VIN+), R34.2, R39.1; also elsewhere on the board
CON1_HEATER_0_VOL: C27.1, R34.1, R35.2; also elsewhere on the board
CON1_HEATER_1: IC17.5 (VIN-), R51.2; also elsewhere on the board
CON1_HEATER_1_CUR: C36.1, R54.2; also elsewhere on the board
CON1_HEATER_1_IN: IC17.4 (VIN+), R46.2, R51.1; also elsewhere on the board
CON1_HEATER_1_VOL: C33.1, R46.1, R47.2; also elsewhere on the board
CON2_HEATER_0: IC15.5 (VIN-), R40.2; also elsewhere on the board
CON2_HEATER_0_CUR: C31.1, R43.2; also elsewhere on the board
CON2_HEATER_0_IN: IC15.4 (VIN+), R36.2, R40.1; also elsewhere on the board
CON2_HEATER_0_VOL: C28.1, R36.1, R37.2; also elsewhere on the board
CON2_HEATER_1: IC18.5 (VIN-), R52.2; also elsewhere on the board
CON2_HEATER_1_CUR: C37.1, R55.2; also elsewhere on the board
CON2_HEATER_1_IN: IC18.4 (VIN+), R48.2, R52.1; also elsewhere on the board
CON2_HEATER_1_VOL: C34.1, R48.1, R49.2; also elsewhere on the board
HEATER0_AD_OUT0: IC13.1 (VOUT), R41.1
HEATER0_AD_OUT1: IC16.1 (VOUT), R53.1
HEATER1_AD_OUT0: IC14.1 (VOUT), R42.1
HEATER1_AD_OUT1: IC17.1 (VOUT), R54.1
HEATER2_AD_OUT0: IC15.1 (VOUT), R43.1
HEATER2_AD_OUT1: IC18.1 (VOUT), R55.1

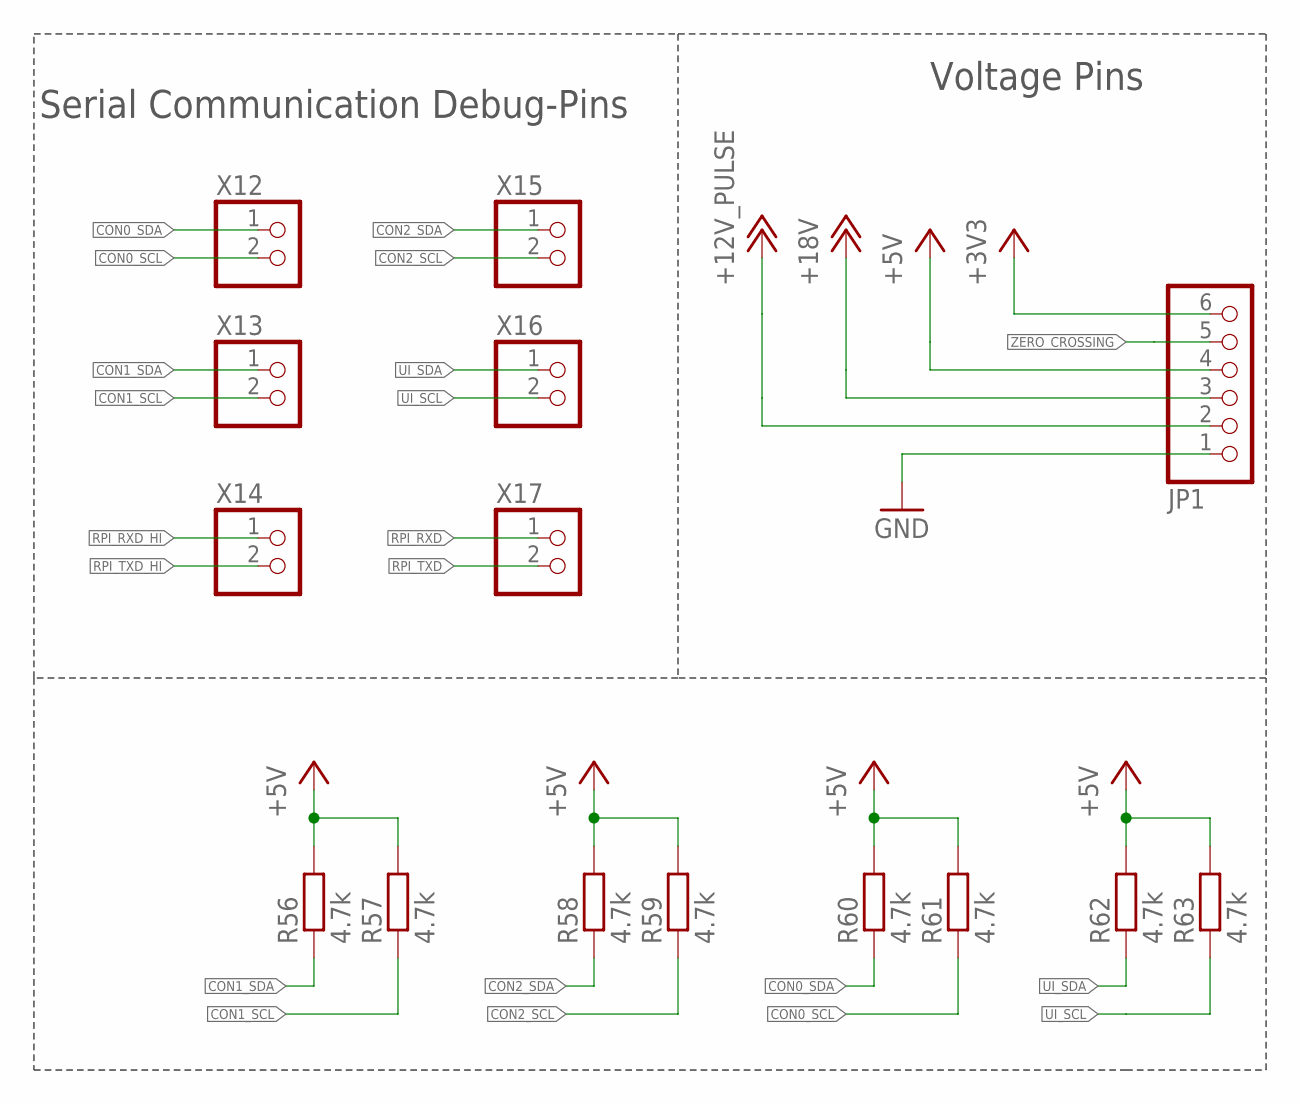
[picture p22: schematic controller.sch, sheet 6]

Parts:
JP1: PINHD-1X6; 1X06
R56, R57, R58, R59, R60, R61, R62, R63: 4.7k; R0603
X12, X13, X14, X15, X16, X17: PINHD-1X2; 1X02

Connections:
+3V3: JP1.6; also elsewhere on the board
+5V: JP1.4, R56.2, R57.2, R58.2, R59.2, R60.2, R61.2, R62.2, R63.2; also elsewhere on the board
+12V_PULSE: JP1.2; also elsewhere on the board
+18V: JP1.3; also elsewhere on the board
CON0_SCL: R61.1, X12.2; also elsewhere on the board
CON0_SDA: R60.1, X12.1; also elsewhere on the board
CON1_SCL: R57.1, X13.2; also elsewhere on the board
CON1_SDA: R56.1, X13.1; also elsewhere on the board
CON2_SCL: R59.1, X15.2; also elsewhere on the board
CON2_SDA: R58.1, X15.1; also elsewhere on the board
GND: JP1.1; also elsewhere on the board
RPI_RXD: X17.1; also elsewhere on the board
RPI_RXD_HI: X14.1; also elsewhere on the board
RPI_TXD: X17.2; also elsewhere on the board
RPI_TXD_HI: X14.2; also elsewhere on the board
UI_SCL: R63.1, X16.2; also elsewhere on the board
UI_SDA: R62.1, X16.1; also elsewhere on the board
ZERO_CROSSING: JP1.5; also elsewhere on the board

Notes on the sheet:
Serial Communication Debug-Pins
Voltage Pins

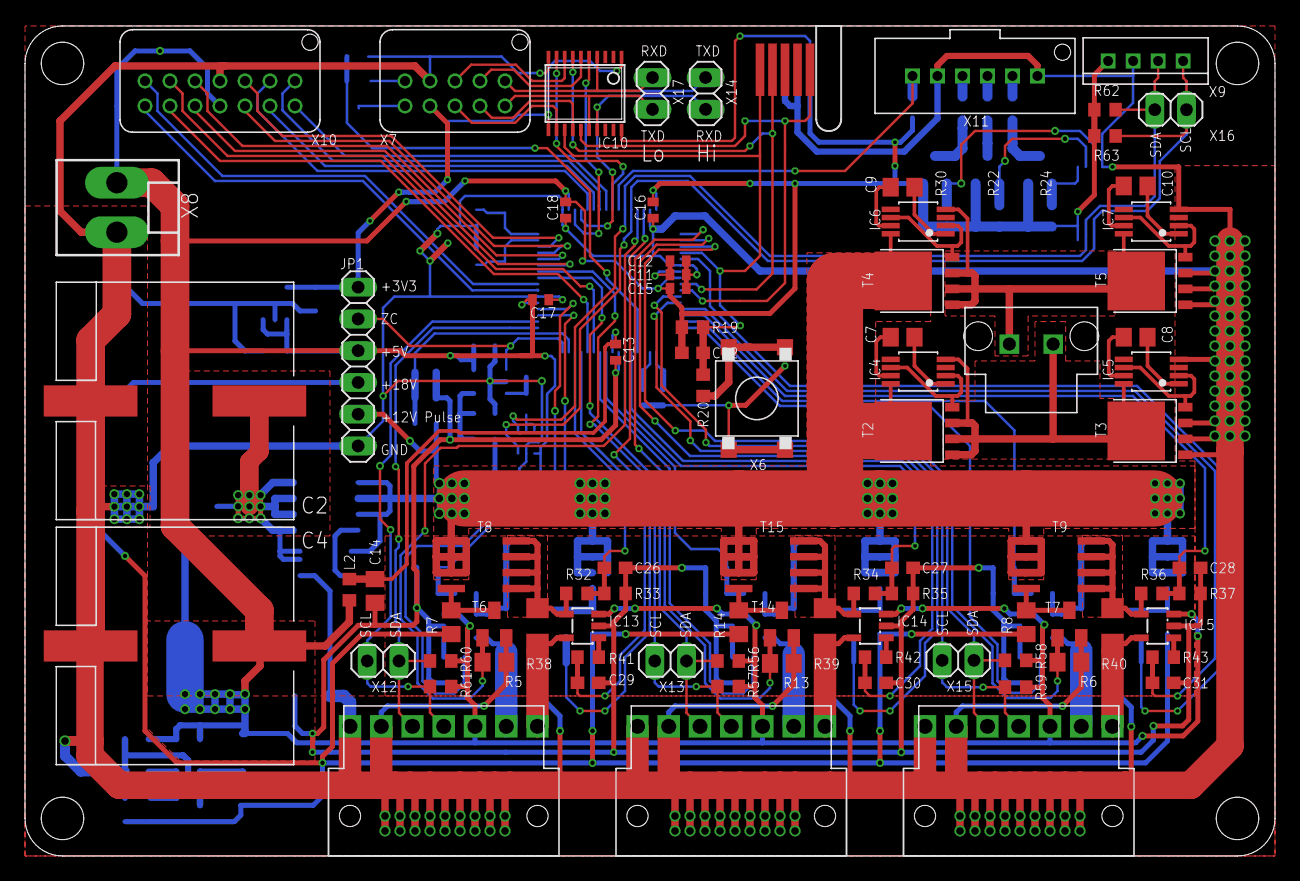
[picture p23: board controller.brd from above]

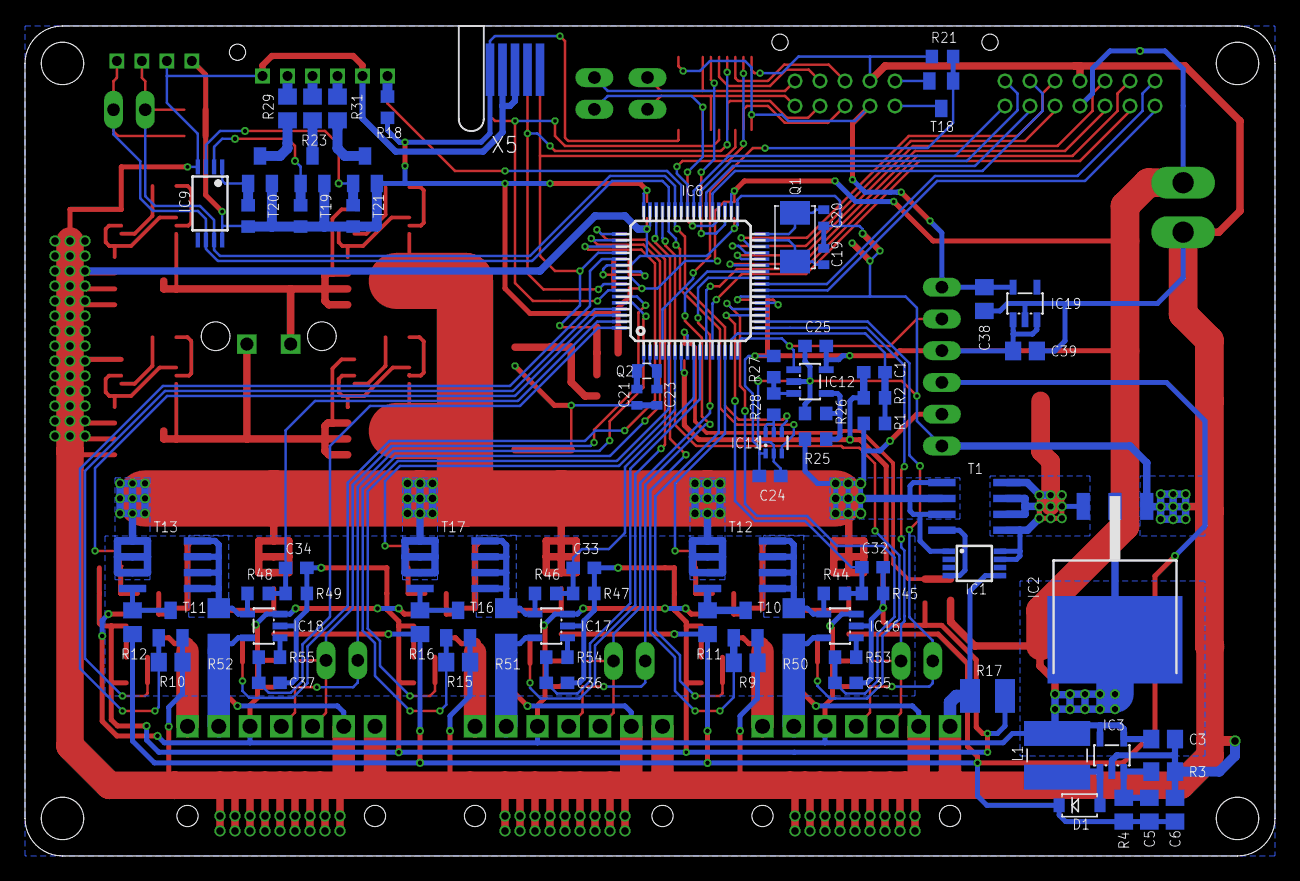
[picture p24: board controller.brd from below]

Board: 2 copper layers, 100.0 x 66.4 mm, 165 parts (80 on the bottom side), 123 nets.
