sebabelz/SolderPi/pcb/iron.brd

## EAGLE design pcb/iron.brd (2018-05-08)

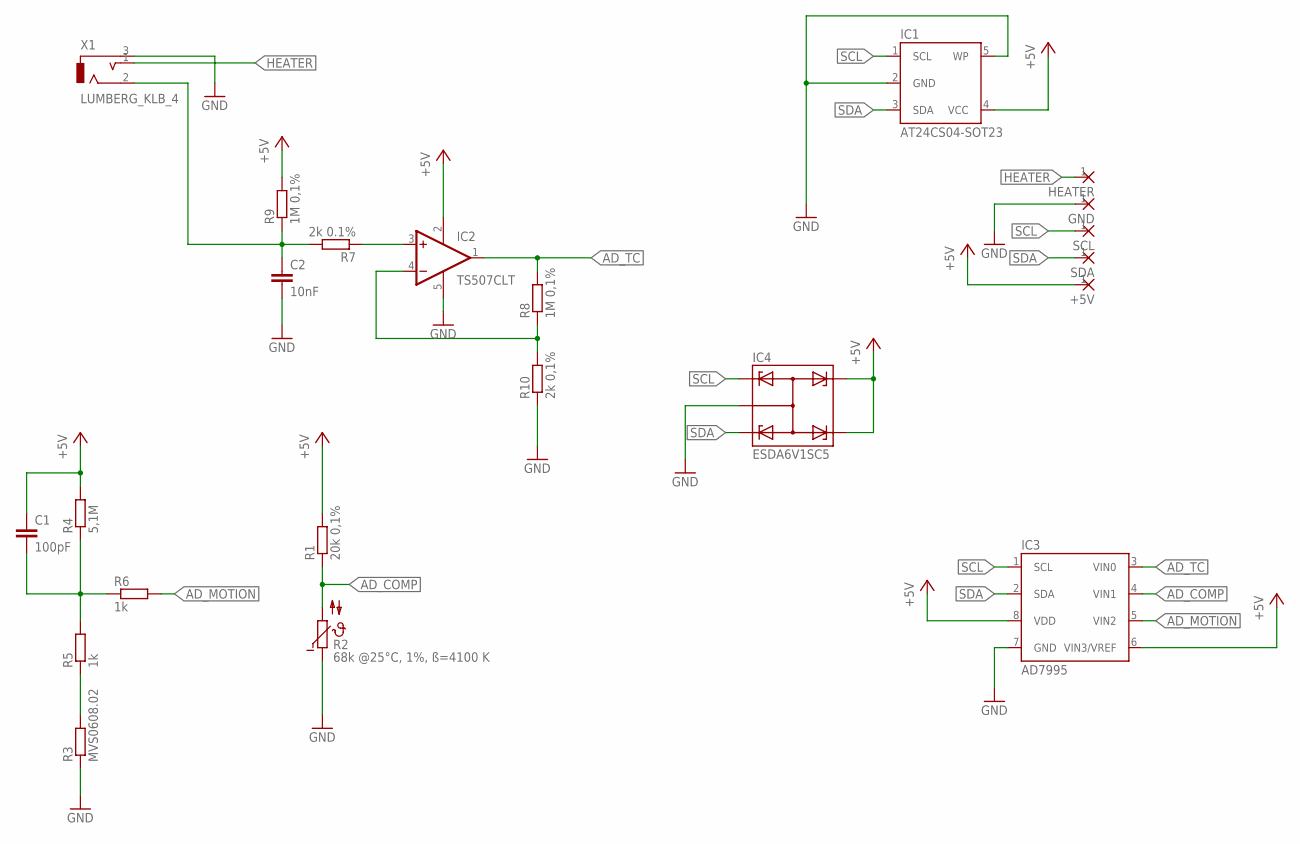
[picture p25: schematic iron.sch]

Parts:
+5V: 1,6/0,8
C1: 100pF; C0805
C2: 10nF; C0805
GND: 1,6/0,8
HEATER: 1,6/0,8
IC1: AT24CS04-SOT23; SOT23-5L
IC2: TS507CLT; SOT23-5L
IC3: AD7995; SOT23-8
IC4: ESDA6V1SC5; SOT23-5L
R1: 20k 0,1%; R0805
R2: 68k @25°C, 1%, ß=4100 K; R0805
R3: MVS0608.02; VIBRA-SNS
R4: 5,1M; R0805
R5, R6: 1k; R0805
R7: 2k 0.1%; R0805
R8, R9: 1M 0,1%; R0805
R10: 2k 0,1%; R0805
SCL: 1,6/0,8
SDA: 1,6/0,8
X1: LUMBERG_KLB_4; 3.5_MM_AUDIO_JACK

Connections:
+5V: +5V.1, C1.1, IC1.4 (VCC), IC2.2 (V+), IC3.6 (VIN3/VREF), IC3.8 (VDD), IC4.4, IC4.5, R1.2, R4.2, R9.2
AD_COMP: IC3.4 (VIN1), R1.1, R2.2
AD_MOTION: IC3.5 (VIN2), R6.2
AD_TC: IC2.1 (OUT), IC3.3 (VIN0), R8.2
FEEDBACK: IC2.4 (-IN), R8.1, R10.2
GND: C2.2, GND.1, IC1.2 (GND), IC1.5 (WP), IC2.5 (V-), IC3.7 (GND), IC4.2, R2.1, R3.P$1 (1), R10.1, X1.3
HEATER: HEATER.1, X1.1
MOTION_DIV: R3.P$2 (2), R5.1
MOTION_FIL: C1.2, R4.1, R5.2, R6.1
SCL: IC1.1 (SCL), IC3.1 (SCL), IC4.1, SCL.1
SDA: IC1.3 (SDA), IC3.2 (SDA), IC4.3, SDA.1
THERMO_FIL: IC2.3 (+IN), R7.1
THERMO_UNFIL: C2.1, R7.2, R9.1, X1.2

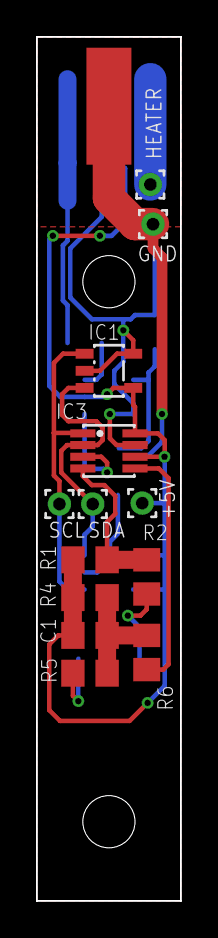
[picture p26: board iron.brd from above]

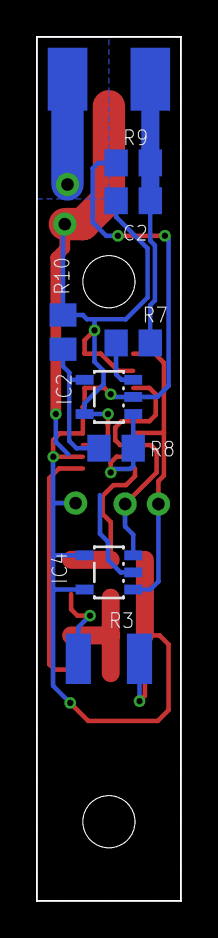
[picture p27: board iron.brd from below]

Board: 2 copper layers, 8.0 x 48.0 mm, 22 parts (8 on the bottom side), 13 nets.
