sebabelz/SolderPi/(commit log)

2018-05-06 pcbs added
    [controller.brd, controller.csv, controller.sch, display.brd, display.csv, display.sch, encoder.brd, encoder.csv]
2018-05-06 bom added
    [bom.xlsx]
2018-05-06 changed bom
    [display.xlsx, encoder.xlsx, iron.xlsx, tweezer.xlsx]
2018-05-08 reworked current path on boards and added new gerber files
    [iron.brd, simple_controller.brd, simple_controller.sch, tweezer.brd, tweezer.sch]
2018-05-15 added simple encoder
    [controller.brd, display.brd, encoder.brd, simple_encoder.brd, simple_encoder.sch, tweezer.brd]
2018-05-25 updated simple controller, simple encoder
    [simple_controller.brd, simple_controller.sch, simple_encoder.brd, simple_encoder.sch]
